cribskip/esp8266_spa/esp8266_spa.jpg

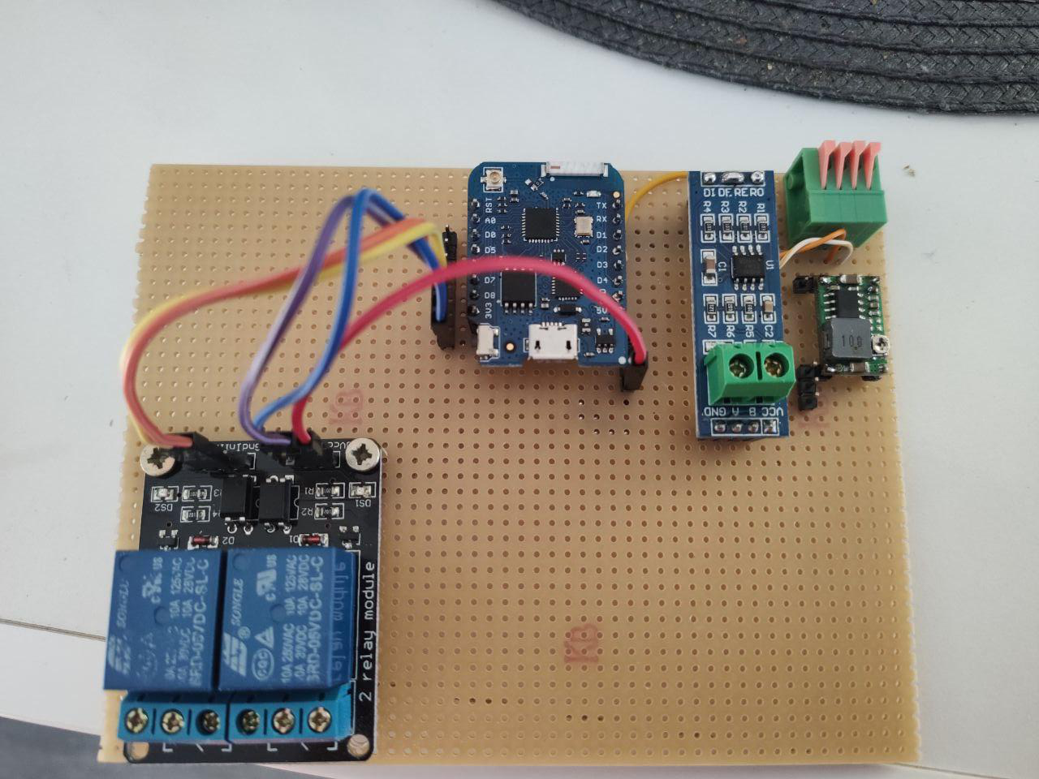
esp8266_spa.jpg
