cribskip/esp8266_spa/(threads)

Thread 1 (2020-08-14):

Not compiling?

tmjo, 2020-08-14:
Hi cribskip! I found your repo when googling for an ESP library for Balboa. I've successfully done a few ESP8266 projects before, but I'm no expert. When I try to compile and upload your code to my ESP, it fails to compile with the following messages:

```
balboa_helper:1:14: error: 'CircularBuffer' was not declared in this scope
 inline uint8_t crc8(CircularBuffer<uint8_t, 35> &data) {
              ^
balboa_helper:1:36: error: expected primary-expression before ',' token
 inline uint8_t crc8(CircularBuffer<uint8_t, 35> &data) {
                                    ^
balboa_helper:1:43: error: 'data' was not declared in this scope
 inline uint8_t crc8(CircularBuffer<uint8_t, 35> &data) {
                                           ^
balboa_helper:1:47: error: expression list treated as compound expression in initializer [-fpermissive]
 inline uint8_t crc8(CircularBuffer<uint8_t, 35> &data) {
                                               ^
esp8266_Spa:53:16: error: variable or field 'print_msg' declared void
 void print_msg(CircularBuffer<uint8_t, 35> &data) {
                ^
esp8266_Spa:53:16: error: 'CircularBuffer' was not declared in this scope
esp8266_Spa:53:38: error: expected primary-expression before ',' token
 void print_msg(CircularBuffer<uint8_t, 35> &data) {
                                      ^
esp8266_Spa:53:45: error: 'data' was not declared in this scope
 void print_msg(CircularBuffer<uint8_t, 35> &data) {
                                             ^
balboa_helper:1:21: error: 'crc8' declared as an 'inline' variable
 inline uint8_t crc8(CircularBuffer<uint8_t, 35> &data) {
                     ^
balboa_helper:1:21: error: redefinition of 'uint8_t crc8'
balboa_helper:1:9: error: 'uint8_t crc8' previously defined here
 inline uint8_t crc8(CircularBuffer<uint8_t, 35> &data) {
         ^
balboa_helper:1:21: error: 'CircularBuffer' was not declared in this scope
 inline uint8_t crc8(CircularBuffer<uint8_t, 35> &data) {
                     ^
balboa_helper:1:43: error: expected primary-expression before ',' token
 inline uint8_t crc8(CircularBuffer<uint8_t, 35> &data) {
                                           ^
balboa_helper:1:50: error: 'data' was not declared in this scope
 inline uint8_t crc8(CircularBuffer<uint8_t, 35> &data) {
                                                  ^
```

It's probably me or my setup, but I would very much appreciate if you could guide me on the way. Using latest Arduino IDE (1.8.13) and already included the required libraries. If I can get it running I would be more than happy to contribute with testing and further development.

Thx.

cribskip, 2020-08-14:
Hi tmjo,

thanks for pointing out. I've seen the code is incomplete. I'll fix it
tomorrow and please check again.

Best regards

tmjo <notifications@github.com> schrieb am Fr., 14. Aug. 2020, 19:11:

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

tmjo, 2020-08-15:
That's awesome! Thanks!!

cribskip, 2020-08-15:
Ok, so I've updated the code to keep up to my local copy. Fixed the missing file and referenced the dependencies (Please install from the Arduino IDE's library manager)

tmjo, 2020-08-15:
Thank you! I tried the new file, but still get the same compilation errors. Read something about the compiler being weird sometimes when it comes to inline functions. Do you know if you have setup anything special to make sure it recognizes the balboa_helper correctly?

I'll do some digging. I should be able to compile it if you are running it, so it must be something with my setup vs yours I guess.

tmjo, 2020-08-16:
Hi again! I think I kindof found the issue. Could it be that your local project folder is "esp8266_**S**pa" with capital S while the github repo is "esp8266_**s**pa"?? Perhaps github is forcing lower case names? Don't even know how I got onto that track, but my folder was all lower case while the main file was with capital letter. This seems to give me the errors that I described in my initial post. Both renaming the folder to capital S or renaming the main file to lower case s removed all those funny compilation errors. Seems strange to me, Arduino IDE was already giving me an error since my initial folder name was directly from the Github download and included "-master" in its name, so I changed to just "esp8266_spa", but it didn't at all complain about the upper/lower case thing. I was able to reproduce the issue both ways several times.

Once that was solved, I still got one compilation error....
```
esp8266_spa:160:24: error: 'class String' has no member named 'toDouble'
     double d = payload.toDouble();

```
.... which seems strange. I googled and found the _toDouble()_ everywhere, but also stumbled over some suggestions of using _toFloat()_ instead.  Replaced line 160 from  _double d = payload.toDouble();_ to float _d = payload.toFloat();_ and it compiles fine. This seems odd to me, but could it be that it has been removed somehow from the Arduino?? As mentioned before, I'm using the latest 1.8.13 of Arduino IDE - do you mind me asking which version you are using? Couldn't find any references on google on if/why it is removed, and it seems odd if it is, so I don't know....

Anyway, now it is compiling, so I'll try it live on my tub tomorrow! Thx.

cribskip, 2020-08-16:
Thank you for your investigations, tmjo :-)
Always great to see helpful people like you.

I'm using Arduino 1.8.12 with esp SDK 2.7.2.

Your guess concerning different names is right - I'm using OpenSpa and renamed it for clarity on github. There I may have introduced the naming trouble. I'll fix it ASAP.

Good luck and keep safe, turn off power.

The code has a problem but mitigatable: https://github.com/cribskip/esp8266_spa/issues/2

tmjo, 2020-08-16:
Great! I thought my esp sdk was updated, but turned out I was on v.2.3.0. Have a vague memory of having to downgrade some time back due to some problems on a previous project, but now I updated to latest v2.7.4 and the toDouble() is working fine. Must have happened something there in between versions.

Another thing, completely unrelated to the "issue", but I'll give it a shot anyway: I just found out that my Balboa panel is connected with a 8-pin Molex and not 4-pin as documented on the ccutrer/balboa_worldwide_app repo. Tried to measure, but found 10V instead of 12V and several 5V instead of 2-3V. Need to investigate a bit more before trying to connect. Any chance you've seen anything about the subject? You have the 4-pin Molex?

tmjo, 2020-08-16:
Closing the issue, thanks for your help!

Closed 2020-08-16.

Thread 4 (2020-10-15):

Topic only shows me Spa/node ON

Magfel, 2020-10-15:
Hi,
I like this project, thanks a lot.
I did all you recommand but when when I include MQTT client, the only command founded is "Spa/Node" with the status ON.
Can you explain me why ? My jeedom seems communicate right with the Wemos D1 Mini pro but not with th tub.

cribskip, 2020-10-16:
Hi,
thank you for the heads up.
Please subscribe to Spa/# as you will then see debug messages on /debug.

In the code are several places with comments to higher the verbosity. Please test these.

Which spa controller are you using? There are differences between controller versions which may cause a problem.

Wemos d1 mini is right.

Magfel, 2020-10-16:
I have a Balboa BP2100G1.
When I suscribe to Spa/# I have only the Spa/node information with a ON status.
Once, I've seen the debug information witch returned -2 ou -4 value, I think.

cribskip, 2020-10-17:
I have the BP2100G0.

| I've set the DC-DC converter to 5V to power the Wemos D1, is it right ?
Perfect :-)

| Is it possible A and B wires inverted ?
That may be the case, please swap them and try again.

Debug is used for several informations. When reconnecting, it publishes the MQTT state before the reconnect (e.g. TImeout etc.) [Docs](https://pubsubclient.knolleary.net/api#state)

Magfel, 2020-10-26:
OK, I have a BP2100G0 too, it was a mistake from me cause I'd downloaded the BP2100G1 datasheet.
Now, it works fine since I've change the Wemos card to an original WEMOS D1 mini pro, I don't known what was the problem with the first one.
I've added a few lines of code to have the possibility of uploading the sketch through the wireless connection.
And I have put all the electronic components in a 3D printed case
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

cribskip, 2020-10-26:
Nice to hear it's working for you also :-)

HTTP-Updater ist already implemented: https://github.com/cribskip/esp8266_spa/blob/b1cb9cef590acb9f651b07251ffd164370011b81/esp8266_spa.ino#L209

Sweat case, could you please post a picture from your setup inside?

Magfel, 2020-10-26:
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
Is is a beta version, I'm going to do one larger.
How do http-updater works ? When I go to the page \\192.168.0.164, I have a blank page with "Not found: /" written on the top left.

cribskip, 2020-10-26:
Use http://ip/update
If asked, use user admin, blank password

Neat setup compared to mine 😅

Magfel <notifications@github.com> schrieb am Mo., 26. Okt. 2020, 20:47:

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

Magfel, 2020-10-27:
Thanks :-)
_Use http://ip/update_ it works, but I prefer using OTA version.
I know why my first "Wemos" card didn't work. On these cards, the pin D1 is the GPIO5 !!!

EmmanuelLM, 2020-12-24:
> Thanks :-)
> _Use http://ip/update_ it works, but I prefer using OTA version.
> I know why my first "Wemos" card didn't work. On these cards, the pin D1 is the GPIO5 !!!

Hi @Magfel I am experiencing the same issue as you but don't understand your last comment as D1 is GPIO5 on my Wemos D1 Pro?? :-/

Magfel, 2020-12-24:
EmmanuelLM,
Try a little program using D1 linked to a LED and test it to be sure it's the real pin used by the program. It was the problem with a copy of the Wemos PRO.

EmmanuelLM, 2020-12-26:
I just checked this and D1 is indeed D1 ... I double-checked my chip as well, which seems to work.
It definitely feels like a hardware issue rather than a software one, but I cannot understand why the program would only post ON and not post the other messages right after it....

cribskip, 2020-12-26:
Excuse me, I'm late back to the discussion ;-)

@EmmanuelLM Did you see this Hint in the code and test it out? Please also post a picture of your setup, thanks
https://github.com/cribskip/esp8266_spa/blob/5f867a4486b858caddb717e2fb8187c5919024d6/esp8266_spa.ino#L245

EmmanuelLM, 2020-12-26:
I did yes, when I get something, it is 254... in fairness, I wonder if my cable is at fault, so I have ordered a new one and will report back when it arrives next week.

EmmanuelLM, 2020-12-30:
I am back with a new cable and still the same issue.... I also noted that the node timeouts every few seconds from the mqtt broker (Mosquitto) and that going to http://ip/update also produces a ERR_CONNECTION_TIMED_OUT - it makes me wonder if the problem is perhaps linked to the network? looks like the node may be trying to reconnect on a regular basis hence the constant Node ON messages... but I don't fully get why I don't receive the debug messages at that point as well...

EmmanuelLM, 2020-12-30:
One other question / possibility why it could not work - I see the Max485 breakout board is a 5V logic vs the wemos d1 mini pro is 3.3v logic, which makes me wonder if the RX/TX are 'overdriven' at 5v, which could cause issues...?

pengemetal, 2020-12-30:
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

Hi Everybody,

I am very happy to find this topic! :). I have the same Balboa BP2100G1 control panel. Could you explain where i can plug Wemos D1 to the panel? The J34 wifi socket? And the DC-DC converter, is it coming from Led 12V? Could you give me some more information about wiring? Thx in advance

cribskip, 2020-12-30:
@EmmanuelLM
Ok, so your cable seems to be good. Maybe the wifi distance is your problem but in this case, you may still see the RECONNECT message. What's the Reconnect reason when the node reconnects? How many millis has the node been running? Or do you ONLY see Node Online?

@pengemetal
Yes, you are right, the hook up documentations is rather sparse ;-) The stock display has a 4 pin molex-type connector with +12...15V, GND and A+B. All connections are on the wire and needed. Please also see the referenced https://github.com/ccutrer/balboa_worldwide_app/wiki#physical-layer for further details. The LED 12V supply for the RGB lighting in the spa is NOT being used.

Testing for correct cabling to the SPA, you can also hook up a USB TTL UART to the RO Pin of the Max485 and bridge RE/DE to GND. You should see plausible data at 115200 8N1.

EmmanuelLM, 2020-12-30:
Hi, I don't see the reconnect message, and spa/debug reports -1 (when it does), with a spa/rcv of 254.

cribskip, 2020-12-30:
Just for testing, please swap a and b

pengemetal, 2020-12-30:
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

Thank you for your answer! Just one more question: Could you help mi about relays wiring? What are they doing? Thx

EmmanuelLM, 2020-12-30:
> Just for testing, please swap a and b

Will try, i'll also hook up a usb ttl for kicks!
Did you see my other comment about the max485 being a 5v chip?

cribskip, 2020-12-31:
@EmmanuelLM 5v is OK for newer chip revisions since a few years. Unless you took a trip to the museum you should be fine.

@pengemetal the relays in the picture were to switch on external lamps. Then for J29 (power shedding of the heater) meanwhile, they are near to useless because I've attached a good and cheap heat pump and disconnected the internal heater (code to come)

Magfel, 2020-12-31:
> I am back with a new cable and still the same issue.... I also noted that the node timeouts every few seconds from the mqtt broker (Mosquitto) and that going to http://ip/update also produces a ERR_CONNECTION_TIMED_OUT - it makes me wonder if the problem is perhaps linked to the network? looks like the node may be trying to reconnect on a regular basis hence the constant Node ON messages... but I don't fully get why I don't receive the debug messages at that point as well...

Hi EmmanuelLM, Does the wifi signal strong enough ?

EmmanuelLM, 2020-12-31:
Hi, Wifi is good, i am a few meters away from the router, I have also tried switching A & B with the same result.
The one other difference I can think of vs the native code is the change mqtt.connect to take into account authentication so mqtt.connect("EspSpa", "login", "password")

I have a usb - ttl coming later today so will do a step by step to ensure my tub is actually producing something (the display works so I think the answer is yes) and work my way backwards to diagnose the issue... if helpful to anyone, this device seems to be able to do it all! https://www.ebay.co.uk/i/202172720183

EmmanuelLM, 2020-12-31:
News from the front: it works!!!!
The issue was the RS485 to TTL module that I was using, I ended up swapping it over to a "ARCELI TTL To RS485 Adapter 485 Serial Port UART Level Converter Module 3.3V 5V" and it now works flawlessly. I will push over some changes to the doc to add a diagram and help other people who might come across here.

The only last issue I have is the wemos d1 mini pro does not 'boot' by itself with the current power rail, I need to first connect it to a usb power supply and then it works as expected (including resets...) - how strange...

cribskip, 2020-12-31:
@EmmanuelLM thanks for the update and great it works. Rather strange with the power supply. PR welcome 😅

EmmanuelLM, 2021-01-03:
Hi, I have started making changes to the code, mainly to deal with the following:
- remove the need for D1 with the RS485/TTL converter
- add support for Home Assistant autodiscover support
- deal with spurious temperature readings (not sure if that was just me?)
- shuffle the mqtt message structure and add more debug info
I migrated the files to PlatformIO as I find it easier to develop on that - this does mean the source file is not in the same location as yours and I have not yet figured out how to make a pull request from alternative folder locations... once I do, I will send PRs
You can see changes here in the meantime: https://github.com/EmmanuelLM/esp8266_spa/blob/master/src/esp8266_spa.ino
If you go to the root of the fork, you will see I also updated the documentation, I will send a PR for that

Thread 5 (2020-11-14):

"Nothing to send" not handled correctly?

irekzielinski, 2020-11-14:
Hi. Thanks for your project, it's a great starting point!
While comparing code to the specification I noticed that it's not handling "Nothing to send".
According to: https://github.com/ccutrer/balboa_worldwide_app/wiki#nothing-to-send

"Nothing to send" should be sent when "Clear to Send" is received but we have no update.
Right now code will send "Toggle Item Request" instead with byte 0x00 - this does not seem to be correct.

Here is the amended code (send == 0x00):
```
       if (send == 0xff) {
          // 0xff marks dirty temperature for now
          Q_out.push(id);
          Q_out.push(0xBF);
          Q_out.push(0x20);
          Q_out.push(settemp);
        } else if (send == 0x00){
          // A Nothing to Send message is sent by a client immediately after a Clear to Send message if the client has no messages to send.
          Q_out.push(id);
          Q_out.push(0xBF);
          Q_out.push(0x7);
        } else {
          // Send toggle commands
          Q_out.push(id);
          Q_out.push(0xBF);
          Q_out.push(0x11);
          Q_out.push(send);
          Q_out.push(0x00);
        }
```

Let me know your thoughts.
Cheers,
Irek

cribskip, 2020-11-15:
Thanks Irek, I'll try it out when time (and weather ;-)) permits.

I've deliberately done it this way as it's the same behaviour of the original controller in my case.

Are you also using a balboa spa? Which controller then?

Best,
Sascha

irekzielinski, 2020-11-15:
Hi, interesting that your controller sends 0x11 in this case.
I have Balboa VL600S and it sends 0x7. Possibly both are OK.
Thanks!
Irek

ps. noticed that RO pin is directly to RX in Wemos. I think RO can go up to 5V which is higher than spec for Wemos. I put a level shifter in my implementation (voltage divider would also do). There are people that have wemos working on 5V input pins for years, other say board can get damaged over time. Did you see any long term issues with serial or board stability?

cribskip, 2020-12-26:
Hi,

thanks for your feedback on the VL600s behaviour.

No, it's up and running smooth for about three months. Its up to the chip revision if they can stand 5V in or not. Older revisions did not while newer ones do.

Did you build the project yourself?

Cheers,
Sascha

Magfel, 2020-12-31:
Hi,
I've a similar problem. I can send orders to the tub about 2 hours after powered on the Balboa controller. After this laps time, I can only receive messages and it works all the time. If I have to send another message passed this 2 hours, I have to swith off and on the controller Balboa.  It is probably caused by the byte 0x11 instead of 0x07 as says irekzielinski.
What do you think  ?

irekzielinski, 2020-12-31:
Hi Sascha. Yes I build the project myself - your code was a great help! Thank you.

> EDIT: Just pasted the code you thanksfully provided in and noticed a missing 0 with the message type code. It's 0x07 instead of 0x7. Thank you :)

There is no difference between 0x07 and 0x7 - it is the same value of 7. Might be worth doing this for the esthetic reasons but compiler will generate the same code in both cases.

Kind reagrds,
Irek

irekzielinski, 2021-02-17:
> Hi,
> I've a similar problem. I can send orders to the tub about 2 hours after powered on the Balboa controller. After this laps time, I can only receive messages and it works all the time. If I have to send another message passed this 2 hours, I have to swith off and on the controller Balboa. It is probably caused by the byte 0x11 instead of 0x07 as says irekzielinski.
> What do you think ?

I heavily modified the code - but main difference is that I send 0x11 and use level shifter to convert from 3.3V to 5V when interfacing with RS485. My controller is rock solid - working for months without any reboot, lost connection or change of ID (ID is assigned on first data exchange with Balboa mainboard).
I recommend to do both modification.

cribskip, 2021-02-17:
Thanks for your feedback and optimization recommendations @irekzielinski ! Very apprechiated!

Did you try the current version yet? Very cool with the homeassistant auto detection and configuration parser! Great work from @EmmanuelLM

Closed 2021-11-26.

Thread 7 (2021-02-03):

No Topic messages

w4Rd3n, 2021-02-03:
Hello.
Thank you all for the great work on this.
I have some problems with the fork of Emmanuel:
https://github.com/EmmanuelLM/esp8266_spa

I use a Wemos D1 mini  Pro
and this config:
```
#define VERSION "0.32"
#define WIFI_SSID "TP-Link_F526"
#define WIFI_PASSWORD "******"
#define BROKER "192.168.1.170"
#define BROKER_LOGIN "loxberry"
#define BROKER_PASS "********"
#define AUTO_TX true //flag for the RS485/TTL chip - i.e. do we need to pull D1 or not....
```

At the moment i don't have the spa connectet to the RS485  TTL transceiver.
But anyway i should get some mqtt messages, no ?
I am powering the wemos on the 5V input with my DC-DC converter

So far Wemos is connected to my wifi but i dont receive any spa  message on my broker.
i am subscribed to Spa/# topic.

Here is a photo of the HW:
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

w4Rd3n, 2021-02-03:
I don't use external Antenna on the D1 mini for now. Ping is working but usually 1 of 4 packets are lost wheni execute the command.
The Webserver is not working. it keeps saying connection timeout and then reloads page

cribskip, 2021-02-03:
@EmmanuelLM s fork is tested with me in PR #6 but up to now, my tests were not successful besides the code looking great.

Maybe you should try my current code first to debug potential connectivity issues as it publishes when the wemos connects to the broker.

EmmanuelLM, 2021-02-03:
My fork is "work in progress" ;-)

From my experience, I had issues with the RS485 to TTL transceiver and found [and I do not know why] that the device would just not work if it didn't receive messages (c.f. issue #4)...

I agree with @cribskip - test his code first :)

p.s. #define AUTO_TX true -> this should be false with your transceiver

w4Rd3n, 2021-02-04:
Thanks for your inputs.
For now i only powered the board without the spa connection.
i was assuming i ll get some mqtt messages also without the spa connected.
I will let you know how this continues :)

Michael0yodi, 2021-06-01:
Did you ever find any solution I've similar issue, I can see that it reports to my broker

1622540317: New connection from 172.16.0.121 on port 1883.
{"result": "ok", "data": {}}1622540317: New client connected from 172.16.0.121 as Spa8861 (p2, c1, k10, u'mqttuser').
1622540332: Client Spa8861 has exceeded timeout, disconnecting.
1622540338: New connection from 172.16.0.121 on port 1883.
1622540338: New client connected from 172.16.0.121 as Spa8852 (p2, c1, k10, u'mqttuser').

But no matter if connected or not to the spa I never get any data via mqtt
webserver on D1 just give me this "Not found: /" not sure if expected?

I've it running on usb power without using the dc-dc converter, but since ground is not connected on the rs485 I guess it "should" work, rxd is flashing so looks like data is received

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

EmmanuelLM, 2021-06-03:
Hello, a few things as it looks like you are nearly there.

If you are powering off usb (or anything else), you need all GND to be connected together otherwise the signal 'floats' - likewise, with the hot tub GND.

if you go to the webserver, go to http://you_ip/update - nothing shows in the root as you have seen.

pato-loco, 2021-06-14:
@EmmanuelLM what do you mean with "all GND to be connected together"?

EmmanuelLM, 2021-06-14:
I meant that the following GND connections should all be connected together:
- power supply GND
- circuit GND
- Hot Tub connector GND

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

Michael0yodi, 2021-07-04:
I've tried to make sure that gnd are common with the spa using a dc-dc converter, but it still behaves the same so not sure where to start troubleshooting, any ideas are welcome

pato-loco, 2021-07-04:
> I've tried to make sure that gnd are common with the spa using a dc-dc converter, but it still behaves the same so not sure where to start troubleshooting, any ideas are welcome

put (-) from the DC-converter "in" and (-) from the DC-converter "out" directly together.

Michael0yodi, 2021-07-04:
should I also connect the GND on the RS485 transceiver? I've used RS485 before with no common ground so its a bit strange that its not working at all, could of course be something else also..

tonyfitzs, 2021-09-28:
hi there, I am also having issues with MQTT. as reported above, I can see in the logs of my broker that the D1 Mini running this code is trying to connect to the brocker and its trying to send a message as follows

1632863671: New connection from 10.110.x.x on port 1883.
1632863671: New client connected from 10.110.x.x as Spa1 (p2, c1, k10, u'test').
1632863665: Client Spa1 has exceeded timeout, disconnecting.

but the subscription isnt ever completed before it disconects. i am wondering if the code I am using is the right version (VERSION "0.35"), because the webpage, dosnt do anything either, and based on above it looks like it is suposed to. if I try to hit http://10.110.x.x/update I get a page time out. perhaps I am misunderstanding the purpose of this url, because the documentation has a few gaps, is this an OTA address rather than a webpage that shows you information.

EmmanuelLM, 2021-09-29:
Hey there, thanks for trying the project.
In my experience with this type of issue, the problem ended up being the
RS485 TTL transceiver - the chip reboots itself when it doesn't receive any
messages on the bus, so the behaviour below is expected.

If you have not already, I highly recommend getting the ARCELI TTL To RS485
Adapter 485 Serial Port UART Level Converter Module 3.3V 5V for the simple
reason you don't need to mess about with levels.

If you already have this chip, you can buy a cheap rs485 TTL usb debugger
that you can hook up to your laptop to check messages are coming through.

Good luck!

P.s. the OTA page is just for updates but it won't be available as the
device reboots itself.
P.p.s. there is a newer firmware on my fork

On Tue, 28 Sep 2021, 23:21 Tony Fitzsimmons, ***@***.***>
wrote:

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

tonyfitzs, 2021-09-29:
Hi Emmanuel,

Thank you for taking the time to get back to me. I have high hopes for this project. So first, let me clarify a few things; I have purchased the hardware that you recommended on your GitHub page. That means I have a D1 mini pro, and I also have an  ARCELI TTL To RS485 (https://www.amazon.co.uk/ARCELI-Adapter-Serial-Converter-Module/dp/B07DN115BZas) before I go out and mess around under my house to connect all this up to my spa (My spa is built into the floor of my rear entertainment area) I want to make sure this all works on my workbench. So I also purchased a cheap RS485 to USB (https://i.ebayimg.com/images/g/~n0AAOxyItRTefGv/s-l500.jpg) as well.

I am also going to create a small app to help me with testing using C#. This will basically replicate the spa's settings and generate a simulated message as if your spa was connected to the communication port. Once I have that all working, I will share the project because I think it will be useful for others following after us. So as the first step in that process, I am trying to get basic communications up and running between the Rs485 dongle and the D1 Mini project. This is where I am having a lot of trouble, and im trying to narrow down the variables to make sure it's not my hardware.

So what's happening is I have the d1 mini, and the ARCELI TTL To RS485 all set up, I have installed your code (VERSION "0.35") onto my d1 mini, and I have connected the A and B data lines between the TTL To RS485 and the Rs485 dongle. Once the D1 boots up after loading the code, I open the terminal to see what it is sending (this is the screenshot on the left below) I also open a terminal against the USB port (on the right), and I can clearly see that the D1 is sending messages to the USB dongle, I send a sample message (7e 20 ff af 13 00 00 ff d 2a 00 00 67 67 00 04 00 00 00 00 00 00 00 00 00 66 00 00 00 78 00 00 52 7e) I can see that the D1 mini is responding with

wdt reset
load 0x4010f000, len 3460, room 16
tail 4
chksum 0xcc
load 0x3fff20b8, len 40, room 4
tail 4
chksum 0xc9
csum 0xc9
v000731e0
~ld
fpm close 3
mode : sta(a0:20:a6:0d:d6:ba)
add if0
scandone
state: 0 -> 2 (b0)
state: 2 -> 3 (0)
state: 3 -> 5 (10)
add 0
aid 3
cnt

So far, so good.

***@***.*** ***@***.***

The issue I am now having is that I can't seem to get it to connect to my MQTT broker,

In the broker logs, I get this message repeated over and over again
1632903370: New client connected from 10.110.10.147 as Spa1 (p2, c1, k10, u'test').
1632903386: Client Spa1 has exceeded timeout, disconnecting.
1632903391: New connection from 10.110.10.147 on port 1883.

And I can't see a topic for the spa being generated. Based on what I can see in your code, I think it should be reporting something like Spa/<topic>/<state> but its not.

Anyway, if you can help, I would appreciate it.

Also, I would like to help you out with improving the readme you have created because there are a lot of gaps in the explanation, which makes it a lot hard when you are having trouble like I am. Once I have this all up and running, I would be very happy to re right this for you and send it to you so you can post it if that's of value to you.

Thanks for your time

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

EmmanuelLM, 2021-09-29:
One quick question: the system is not yet hooked up to the Spa, correct? If
that is the case, I don't think the system will work because it will reboot
itself when it doesn't receive messages after a while.

On Wed, 29 Sep 2021, 10:22 Tony Fitzsimmons, ***@***.***>
wrote:

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

tonyfitzs, 2021-09-29:
Yes that's correct.

Ok that makes sense. In that case I will get my little balboa Spa simulator working and revert...

But what about the mgtt question.

Sent from my Galaxy

-------- Original message --------
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

Thread 8 (2021-02-04):

Subscribe doesn't match callback handler

cribskip, 2021-02-04:
https://github.com/cribskip/esp8266_spa/blob/a16ca98d76dbf3ae4b159a9b4e59057b788d7a5f/src/esp8266_spa.ino#L494

Relays wont work this way

Closed 2021-02-04.

Thread 9 (2021-02-05):

RS485 bus transceiver wiring

pengemetal, 2021-02-05:
I have this type of RS485 bus transceiver, could you help me about wiring? Thx
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

EmmanuelLM, 2021-02-14:
Evening, I had a lot of trouble with this transceiver so ended up getting a ARCELI TTL To RS485 Adapter 485 Serial Port UART Level Converter Module 3.3V 5V, so I would recommend getting one of those.
The main differences are:
- it natively runs at 3.3v or 5V
- you don't have to mess about with pulling D1 to transmit data
- it has some flashing lights that shows data being received / sent [helpful for debugging connections]

pengemetal, 2021-02-15:
Thx, I'll try to order this  transceiver!

pengemetal, 2021-03-31:
Hi, All parts have arrived I would start to make the connection. One question: I haven't got molex cable or Y splitter, is it possible to cut the display cable and with some Wago make DIY y-splitter cable? How did you wire to the motherboard? Thx!

EmmanuelLM, 2021-03-31:
I mean... everything is possible and what you suggest is (in essence) a Y-slitter.
I got a mini Molex cable and connected to the spare port.

One question for you (and whoever else is ready this) - would there be any interest in buying a made-up system? Thinking out loud, I am thinking the whole system + 3d printed case would probably come to ~50USD or so?

EspenT, 2021-03-31:
Yes, for 50usd I would buy 😊 I´ve been following this thread forever and probably have everything I would need to make it, except time.

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

pengemetal, 2021-03-31:
Thx for the quick answer! I think it is a fair price for it!

EmmanuelLM, 2021-04-01:
Sounds like I need to have a look at getting the wifi hotspot working then!

cribskip, 2021-04-02:
@EmmanuelLM please add a connector for J2 (IIRC) to control the heater. That way controlling the circulation is possible and other cool things.

Currently I use a relay but an transistor should suffice

mopac, 2021-07-06:
I realise it is a little late for the original poster, but just for completeness, I show here my schematic and a few photos of how I used this RS485 board.
I use a D1mini power sheild to regulate the hot tub 12V supply down to 5V for the RS485 board and the D1 Mini Pro. (D1 Mini Pro has its own regulator from 5V down to 3.3V.
The RS485 board is 5V, while D1 mini Pro is 3.3V. All outputs from D1 Mini Pro work just fine with a direct connection. The RX input - RO output from the RS485 board is the only issue. The fix is a schottky diode in this signal line. Schottky diode because of the low forward voltage. I used a BAT43 diode.
Tx & Rx used for the RS485 board are also connected to the USB-UART converter on the D1 Mini Pro but there are 470 ohm series resistors so they can be overdriven.
I use GPIO13 & GPIO15 for enabling the Receiver and Transmitter respectively. This is because GPIO13 has a pull-up on the D1 mini and GPIO15 has a pull-down. So if software doesn't configure these GPIO, the RS485 board is disabled. The benefit is that Serial download still works.
The only annoying tweak is that R3 on the RS485 board needs to be removed. This is a pull-up resistor that conflicts with the pull-down resistor on the GPIO15 on D1 mini Pro.
The only changes in the code are to configure the two GPIO as outputs and set LOW in the 'Setup' function. And ensure both GPIO are set HIGH then LOW in the 'rs485_send' function
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

Closed 2022-01-10.

Thread 11 (2021-04-05):

Wemos keeps resetting

micv83, 2021-04-05:
I’ve tried with 2 different wemos d1 mini, but after it connects to WiFi it disconnects again crashes with wdt reset.

what Couple be wrong ?

cribskip, 2021-04-05:
Power Supply ok?
Please post a photo of your setup

micv83, 2021-04-05:
The resets occurs even when hooked up to the laptop via usb, with only the Wemos - no regulator or rs485 attached. I have also tried standalone setup with 12v psu through regulator with rs485 attached.
I do get connection attempts in mosquito in home assistant, so it does something before it crashes...

Like this:
1617639019: New connection from 192.168.1.78 on port 1883.
1617639019: New client connected from 192.168.1.78 as Spa1 (p2, c1, k10, u'mqtt').
1617639034: Client Spa1 has exceeded timeout, disconnecting.

EmmanuelLM, 2021-04-06:
Hi, in my experience the device resets when it doesn't receive messages from the hot tub (see: https://github.com/cribskip/esp8266_spa/issues/7#issuecomment-772675742).

I am afraid you're going to have to hook it up to resolve that one :)

micv83, 2021-04-06:
Thank you srasmond - this was the issue, it stays connected now, and I am more confident trying to connect it to the spa now 😊👍🏼

cribskip, 2021-04-06:
@micv83 Good luck then! What controller do you have?

micv83, 2021-04-07:
It’s a Balboa bp6013g1 hope it works 😊

srasmond, 2021-04-07:
> It’s a Balboa bp6013g1 hope it works 😊

I got the same. Works brilliant, I control it via OpenHAB (Mosquito as broker). Already quite some things you can monitor or change

EmmanuelLM, 2021-04-07:
Hey @srasmond - what other features would you like to see implemented? I am currently working on an access point mode, so I can start releasing binaries, which would make the initial setup much easier, but wondering whether there are other things I could also knock off people's wish list?

cribskip, 2021-04-07:
@EmmanuelLM setting filter cycles and wifi manager would be great.

I'm currently polishing my heat pump controller and write up of the setup and photovoltaik optimization 😉

micv83, 2021-04-07:
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

Managed to get it working, but it’s not all that stable at the moment, but I can see the WiFi signal is very poor, so I’ve ordered a wemos with external antenna connector hope that makes the switches work more reliable 😊

srasmond, 2021-04-09:
@EmmanuelLM I am still playing around with some settings. Currently, my main goal was to set off the heating of the hottub during the night (with a minimum temperature of 21° C, but that is only a concerning during winter). At the moment I am realizing this by setting the "target_temp" lower each night (via openHAB rule). I tried to just turn of the heater and thought it does seem to work, there seems to be 2 issues in this scenario:
- If you don't use the hottub for some hours, the temperature will actually be a "null" value, which requires to turn on the jets for a couple of seconds.
- If you turn on the jets, it seems like no matter what, the heating mode is overruled and it heats up anyway.
- Because of this you cannot continuously compare the current temperature, nor have a trustworthy method of turning of the heater.

--> Setting the target temperature provides a more ensuring way that the hottub will indeed not heat during that amount of time and as a plus, it seems like in this case you get continously updates current temperature values.

Other things I am thinking about:
- Filter cycles, but I see that there is a pull request for this, this seems like a really nice addition! Thanks!
- Setting the time (needs to be done manually now after hot tub is turned off or changing of winter- to summertime) --> important for the filter cycles.
- Really nice would be if we had some way of controlling the amount of power that the heater is taking for example. Most of the time, I am using the hottub after 6 PM, so during the day, when I give the chance to heat up, it would be nice if I could spread out the amount of power, so we don't get peaks but a more slower heating up during sun hours (to take full advantage of my solar panels).
- Control over the lights: at the moment I can only turn the lights on or off, but it seems it always is using the light looping mode (so looping over each color) and on a fast pace... Maybe I am using it wrongly at the moment, but if not it would be nice if we could set the color (or looping on/off) and the tempo (in fixed steps probably) of the lighting. In that scenario, I can also imagine that we can read out the current light color value and for example pass it to other smart lights in the house or garden to get a really nice effect.
- The ability to control / turn off the info messages on the panel on the jacuzzi.
- Setting a "vacation" mode: I guess this can be done by setting "heatingmode" to off (=ready vs rest mode)? Or what is the difference between head_mode and heatingmode?

srasmond, 2021-04-09:
@micv83 Getting an external antenna is a good idea. The default is indeed not strong enough (in my case for example, the signal needs to get from inside its case, which is inside the hottub (close to the balboa controller), which stands outside in the garden, to inside my house - to the closest receiver. Considering also the extra interference by all the wiring inside the balboa controller and perhaps even a bluetooth device next to it, getting a decent antenna is the minimum. After that, you should be all good.

cribskip, 2021-04-11:
@srasmond I'll try to answer to your rather long text structured ;-)

Heater off during winter:
You're right, when the temp is low AND "Balboa M7" "Artificial Intelligence Blockchain Crypto" is turned OFF, you're getting 0 as current temperature as the temperature is unknown to the controller. When M7 is on, the tub starts the circulation just before invalidating the temperature for a few minutes and knows the temperature again.

When you start the jets, the tub goes into ready-in-rest mode: Meaning it's heating to the Ready-Temperature.

My current setup (which needs to be described more in detail ;-) which circumvents all those problems:
- J2 on the tub mainboard it connected to a relay (J2 controlles wheater the tub is allowed to turn on the heater)
- J2 closed: Heater allowed, J2 open: not allowed
- (I disconnected the immersion heater and installed an external controlled heatpump...)
- When the tub invalidates the temp, I simply open J2 and set the tub to Ready mode. Circ starts and a few minutes later I set mode to Rest.

Some benefits:
- Heating is controlled by the heat pump which is cheaper and more environmently friendly
- A new "circulation only" mode is possible which is great when tubbin' because we have a fountain which is linked to the ever switching circ pump in ready mode...

TL;DR: I need to get my documentation ready. But first: more photovoltaic :-D

srasmond, 2021-04-12:
@cribskip The J2 connector would be my alternative to put a wifi switch relais on if I would not get the controller to work.
Now that I can control the hot tub in many other ways, I don't see an immediate benefit from using the J2 connector, but I am curious on what you mean exactly with the "circulation only" mode?

At the moment I am using the "target_temp" since a couple of days, and I have to say it works really well this way. At 10 pm a script is setting the "target_temp" to 30°C and at 10 am a script is setting the "target_temp" to 38°C again. This also makes sure that the current temperature is always known (during heating up or cooling down moments), which is handy, because now I see how much the T is dropping during the night (at the moment it never drops below 34,5 °C).

When light control, time and power control (will most likely need to be done at input level, not via the controller) is added to my system, for me it will have everything I would ever need.

If I have some time this week I will try to put my system, configuration, use cases, etc. on paper. You can then use whatever you want from it in future documentation.

pengemetal, 2021-04-15:
Hi! I use wemos D1 mini (not pro) how can I check the wifi connection? I can't see nothing in MQTT explorer, I think Wemos do not connect to wifi (SSID and password is correct is src/esp8266_spa.ino. Thx

srasmond, 2021-04-15:
@pengemetal you could try to ping it. If it's connected you should also see it in your network list with all devices. Nornally, when using the code from this repo, the Wemos should broadcast its own SSID as well, so in the list of wifi network it should be visible as well.
Other things you could check is the serial output when connected with the board via usb.

pengemetal, 2021-04-15:
> @pengemetal you could try to ping it. If it's connected you should also see it in your network list with all devices. Nornally, when using the code from this repo, the Wemos should broadcast its own SSID as well, so in the list of wifi network it should be visible as well.
> Other things you could check is the serial output when connected with the board via usb.

Ping do nothing. I can see an ESP-xxxxxx SSID, but I use many esp I don't know it's wemos. I tried Platformio serial monitor, but without any success:
> Executing task in folder esp8266_spa-master: C:\Users\Admin\.platformio\penv\Scripts\pio.exe device monitor <

--- Available filters and text transformations: colorize, debug, default, direct, esp8266_exception_decoder, hexlify, log2file, nocontrol, printable, send_on_enter, time
--- More details at http://bit.ly/pio-monitor-filters
--- Miniterm on COM7  9600,8,N,1 ---
--- Quit: Ctrl+C | Menu: Ctrl+T | Help: Ctrl+T followed by Ctrl+H ---
���␙
��D�������␄!>�@���H!�4�L�����?

pengemetal, 2021-04-15:
At baudrate 115200:

wdt reset
load 0x4010f000, len 3584, room 16
tail 0
chksum 0xb0
csum 0xb0
v2843a5ac
~ld

pengemetal, 2021-04-18:
I tried with a NodeMCU v3, problem the same:

wdt reset
load 0x4010f000, len 3584, room 16
tail 0
chksum 0xb0
csum 0xb0
v2843a5ac
~ld

srasmond, 2021-04-18:
@pengemetal and did you try the solution from higher in this post (disabling the reset function)?

pengemetal, 2021-04-18:
> @pengemetal and did you try the solution from higher in this post (disabling the reset function)?

I need to delete this row?
if (WiFi.status() != WL_CONNECTED) {
//hardreset();
}

Thx

srasmond, 2021-04-18:
No, you just need to comment out the hardreset function where needed. The // in the example you showed is a way of commenting a line (so you don't need to delete it and easily can activate it again afterwards).
For testing I suggest disabling the hardreset for the wifi connection, but also for the serial check (if the device is not hooked up correctly, it will keep resetting as well).

pengemetal, 2021-04-18:
> No, you just need to comment out the hardreset function where needed. The // in the example you showed is a way of commenting a line (so you don't need to delete it and easily can activate it again afterwards).
> For testing I suggest disabling the hardreset for the wifi connection, but also for the serial check (if the device is not hooked up correctly, it will keep resetting as well).

Notthing has changed :( messege still the same

EmmanuelLM, 2021-04-18:
Are you connected to the hot tub yet, or is that solo?

pengemetal, 2021-04-18:
> Are you connected to the hot tub yet, or is that solo?

Both

EmmanuelLM, 2021-04-19:
Looks like a potential compile/flash error as you shouldn't see any ESP-xxxxxx SSID

 Questions to help debug:
- are you using atom/platformio to compile?
- do you know the memory size of your chip?
- A guess is your chip has a lower flash size - have a look at "board_build.ldscript = eagle.flash.4m3m.ld" and change to "board_build.ldscript = eagle.flash.1m0.ld"

srasmond, 2021-04-19:
@EmmanuelLM , why shouldn't you see any SSID? There is nothing in the code that prevents the esp from broadcasting the SSID. I see it as well.
It's a nice tip hoever: people should prevent this broadcasting or put a WPA key on the esp. Else you have a potential security issue at hand.

I do however also believe that there might be some flash error in this case like you suggested. Nice suggestion concerning the lower flash size!

pengemetal, 2021-04-20:
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

Thx for your effort!

- I use platformio (Visual Studio Code win10)
- I use Wemos d1
- I flashed NodeMCU v2 and the result was the same, I think Nodemcu has different chip. I will try your suggestion, where can I change "board_build.ldscript = eagle.flash.1m0.ld"?

pengemetal, 2021-04-21:
I changed it in platformio.ini, but I get this:

Error: Could not find 'eagle.flash.1m0.ld' LD script in LDPATH 'C:\Users\Admin\Downloads\esp8266_spa\esp8266_spa-master\.pio\build\d1_mini_pro C:\Users\Admin\Downloads\esp8266_spa\esp8266_spa-master\.pio\build\d1_mini_pro\ld C:\Users\Admin\.platformio\packages\framework-arduinoespressif8266\tools\sdk\lib C:\Users\Admin\.platformio\packages\framework-arduinoespressif8266\tools\sdk\ld C:\Users\Admin\.platformio\packages\framework-arduinoespressif8266\tools\sdk\libc\xtensa-lx106-elf\lib C:\Users\Admin\.platformio\packages\framework-arduinoespressif8266\tools\sdk\lib\NONOSDK22x_190703'
Error: Could not find 'eagle.flash.1m0.ld' LD script in LDPATH 'C:\Users\Admin\Downloads\esp8266_spa\esp8266_spa-master\.pio\build\d1_mini_pro C:\Users\Admin\Downloads\esp8266_spa\esp8266_spa-master\.pio\build\d1_mini_pro\ld C:\Users\Admin\.platformio\packages\framework-arduinoespressif8266\tools\sdk\lib C:\Users\Admin\.platformio\packages\framework-arduinoespressif8266\tools\sdk\ld C:\Users\Admin\.platformio\packages\framework-arduinoespressif8266\tools\sdk\libc\xtensa-lx106-elf\lib C:\Users\Admin\.platformio\packages\framework-arduinoespressif8266\tools\sdk\lib\NONOSDK22x_190703'

srasmond, 2021-04-21:
Could you try with eagle.flash.1m.ld (so without the "0").
Also a link that could be of intrest in this case :
https://docs.platformio.org/en/latest/platforms/espressif8266.html#flash-size

pengemetal, 2021-04-21:
I tried, flash is perfect, but the wdt fault is still existing :(

srasmond, 2021-04-21:
How is your esp currently powered for testing? I'm guessing you are just plugin it in via an usb adapter to the laptop, so you can check the messages in the serial monitor?

pengemetal, 2021-04-21:
Yes, laptop via usb.

EmmanuelLM, 2021-04-21:
This may not work as terminal is taken over to communicate with the hot tub.
I find your issue very odd - can you try flashing something else on yoru
chip?

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

pengemetal, 2021-04-22:
Yes, I flashed with esphome and worked perfect! I am thinking about using a D1 mini pro. I have one, but it is built for control sauna.

pengemetal, 2021-05-04:
I try a D1 mini pro, almost the same result, but now I can see nothing in serial monitor. I think the main problem is connecting to wifi. I can't see Wemos fixed ip in the network. When I flash esphome, there is no problem.

pengemetal, 2022-01-10:
> @pengemetal Can this be closed? Is your issue resolved and you can enjoy the sketch?

Yes, thank you! It solved, I dont know what was wrong, I think the wifi signal was the problem! Finally the sketch works great! :)

Closed 2022-01-11.

Thread 13 (2021-04-06):

Warning about MT3608 suggestion

srasmond, 2021-04-06:
In the README, we can find the following information: "A DC-DC converter for powering from the Tub (MT3608 for example)".
However, the MT3608 is a step-up converter, while you will definitely want a step-down converter.
Its step-down counterpart for example is the "LM2596".

Just a little warning for those like me who forgot to look into the difference between step-up and step-down converters.

cribskip, 2021-04-06:
Corrected, thank you very much

Closed 2021-04-06.

Thread 15 (2021-04-16):

OTA Update And HASS Client

qwacko, 2021-04-16:
Hi, Thanks heaps for the logic. I had been trying with Micropython to get this going, but I was just unsuccessful at getting it to go. Then just a couple of hour and I got your solution going. It would be great to get this as part of ESPHome, but I think the refresh rate may be too low.

Anyway, I have made a couple of changes to my version of the code to make it work how I wanted, and thought you may appreciate these minor code changes.

**Arduino OTA**
I see you had a note to get OTA to work (and even had the library included). The logic changes to make this are:

Just incude ArduinoOTA.begin(); in the setup task.
`void setup() {
   ...
   ArduinoOTA.begin();
   ...
}
`

And include the ArduinoOTA.handle at the start of the loop:
`void loop() {
  ArduinoOTA.handle();...`

And it will be ready. Once you have done this intial serial download, then you can add the following lines to the platformio.ini file:
```
upload_protocol = espota
upload_port = spa.local
```

And through the magic of mDNS it will be able to do a download to it. This is great for debugging while it is connected to the SPA.

**HASS Client**
I noted that the HASS client was only working for some items. Most markedly the Climate item wasn't working, this is due to the default message length limit of 256B. You may have fixed this by modifying the PubSubClient.h file in your instance (or maybe the climate just hasn't worked for you). To make it work for me, I added the "setBufferSize" comand when the mqtt service is setup.

```
  mqtt.setServer(BROKER.c_str(), 1883);
  mqtt.setCallback(callback);
  mqtt.setKeepAlive(10);
  mqtt.setSocketTimeout(20);
  mqtt.setBufferSize(1024); // Set buffer size to allow discovery messages to work correctly.
```

EmmanuelLM, 2021-04-19:
Sweet - please could you send a pull request vs 0.36 (c.f. my branch)?

also see line 488 for setBufferSize - I had increased it to 512, was that not enough?

flechaig, 2021-12-22:
In my experience with a Balboa BP6013G2, I had to set :
`mqtt.setBufferSize(1024);`
for everything to work as expected.

Gamerayers, 2022-04-19:
Is there any reason that it couldn't be ESPHome?  Are you saying the refresh rate of the ESPHome software runs to slow to grab it off of modbus or simply that the data would be too slow to Home Assistant.  It isn't like you are sending data and needing it in a time critical nature.  Even a couple seconds of delay isn't a big deal.

Thread 16 (2021-04-20):

Problem finding the right pins on the pcb

Warrior700, 2021-04-20:
Hello everybody,

I have a Balboa bp2100g3 board. Unfortunately, I'm not really sure which pins the RS485 transceiver A / B should be connected to. I have a picture of the circuit board, the connector is on the top right. I've found the physical link layer description and I am confused what the meaning is. "It is also recommended to put pin 3 on the return line of the connection device to reduce the common mode voltage." Is It really necessary?

How did you connect your transceiver? A schematic would be helpful.

Many thanks to all the developers of this project.

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

cribskip, 2021-04-20:
Nice picture :-)

Are you able to measure the voltages on the pins? One pair should show +11...15V. So you know GND and Supply.

The other pair shows fluctating low voltages (<3V) to ground. The higher is A, IIRC. Those are interchangeable if it does not work, don't worry. The other two pins are NOT interchangable!!!!

srasmond, 2021-04-21:
@Warrior700 I have the same board layout. I kept it really simple as well:
- I plugged in an ATX Molex Micro Fit Connector 4Pin cable (60cm) in to the J35 plug on the Balboa board (the 2nd 4 pin connector from the top on the right of your picture).
- On the other end of the Molex cable (where I cut off the other connector to have 4 loose wires) you usually have 2 black wires and a yellow and red wire.
- In my case, the 2 black wires where the data connection (A & B), yellow was GND and Red was my power supply.
- **This could differ for you! You definitely need to measure this!**
- I used the Earth cable of my spa to connect my meter's ground with a clamp and then checked DC voltages on each wire.
- GND (0V) and V (+/- 13V in my case) are the easiest to detect and can be attached to your step-down converter.
- A & B are lower voltage and close to each other, but you should see a tiny difference, with the higher VDC one being cable B ("_RS-485 B"_) (cable A should be little lower in VDC, but like cribskip mentioned, no worries if they are connected wrongly, you will get bad messages, but no electrical damage or what so ever, just switch them if necessary on your TTL To RS485 Adapter --> **but like it was mentioned by cribskip always leave GND and V alone!**).
- That's it. No other tricks or cables where used to connect the Balboa board to my custom board.

Warrior700, 2021-04-21:
Thanks for the detailed description, I have a Molex Micro Fit cable like you in stock, also with black, yellow and red. At the weekend I will measure the pins. At first I will only connect RX / TX. For testing, I can also connect the WEMOS via USB and supply the 3.3V + GND via breadboard to the TTL to RS485 pcb. This should be possible, right?

srasmond, 2021-04-21:
For flashing and testing if the ESP can be found on your network and communication is working I just connect the _WEMOS_ via USB.

For testing the Spa communication without supplying power from the Balboa board, yes, you could power your _TTL to RS485_ via the 3.3V and GND pins from the _WEMOS_ if its connected via USB.

If that is working, ideally, before moving on, I would also test it without powering the _WEMOS_ via USB, but for example by wiring everything up and connecting an other 5V power source, so you could test the output of the step-down converter (which should be 3.3V) and receive your MQTT messages.
I made my PCB so that I could easily plug in and out both the _TTL to RS485_ and _WEMOS_ boards.
That way I could also double check my output voltage from the converter when it's straightly connected to the Balboa board before endangering my components on the PCB.

Michael0yodi, 2021-05-19:
What are the expected voltages? I've read that it should be ~3volt on RS485 but this is my readings, am i good or do you think somethings is wrong?
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

cribskip, 2021-05-19:
Perfect, go for it. You identified supply and gnd. If you mix up rs485 a
and b just swap them

Michael ***@***.***> schrieb am Mi., 19. Mai 2021, 14:23:

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

flechaig, 2021-12-22:
In my experience, with a Balboa BP613G2, the pinout is exactly the same.

Thread 17 (2021-06-09):

no connection, no messages

pato-loco, 2021-06-09:
Hello everybody,

I am desperate about this project right now.

My config:
- BP2100 (Spatech)
- WEMOS D1 mini pro (including external antenna)
- ARCELI TTL To RS485 Adapter 485 Serial Port UART Level Converter Module 3.3V 5V
- LM2596 (set to 3.3V)

What happened until now:
- Adoption of version 0.34
- Adaptation to my environment (SSID, PWD, Broker, Brk_Login, Brk_pwd)
- no connection to the WLAN recognizable

Then change by me:
- //Serial.println("millis-Hrest ");
- // hardreset ();

Result:
- no hard reset
- MQTT client send a message to MQTT server if connected
=> WLAN probably has enough time to connect and the MQTT server receives a "connection" confirmation
- that's all

Problem:
It doesn't matter whether I connect the spa or not
(RX flashes when connected), I do not receive any messages via MQTT.
When entering http://my_ip/update I only get the option for OTA update. No login process.
The default website then shows "Not found: / config".

I am happy about any kind of support.

Thanks in advance!

pato-loco, 2021-06-09:
Hi Sascha,

thank you for your fast response. And thank you for your great work :-)

Mhh, from my sight of view I have done all things, what is wright down in the readme.
I´ve also crossed A and B from the Spa. No connection to Wifi (without passing the hardreset).

The Wifi-Client connects to Wifi if I commend out "//Serial.println("millis-Hrest ");"
So I think, the Wifi range is sufficient.

In one of the "Issue-comments" I read about, that I have to bring "all" GND to one point. What does it mean?
Should I also bring GND (-) from Spa-In (-) to a common point?

And is there a chance to "debug" the input signal from the spa to the serial console or to mqtt?

pato-loco, 2021-06-09:
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

pato-loco, 2021-06-09:
// https://github.com/ccutrer/balboa_worldwide_app/blob/master/doc/protocol.md
// Reference:https://github.com/ccutrer/balboa_worldwide_app/wiki

// Please install the needed dependencies:
// CircularBuffer
// PubSubClient

// TODO:
// HomeAssistant autodiscover - mostly done
// Configuration handling
// Proper states (rather than just ON/OFF)
// OTA update from Firebase
// Settings
// Implement Existing Client Request/Response
// Handle non-CTS Client IDs

// +12V RED
// GND  BLACK
// A    YELLOW
// B    WHITE
#include <LittleFS.h>
#include <ArduinoJson.h>
#include <ESP8266WiFi.h>
#include <CircularBuffer.h>
#include <ESP8266WebServer.h>   // Local WebServer used to serve the configuration portal
#include <ESP8266mDNS.h>
#include <ESP8266HTTPUpdateServer.h>
#include <ArduinoOTA.h>
#include <PubSubClient.h>       // MQTT client

#define VERSION "0.35_1"
const char* HOSTNAME = "hottube";
String WIFI_SSID = ":-)";
String WIFI_PASSWORD = ":-)";
String BROKER = "192.168.9.44";
String BROKER_LOGIN = "foo";
String BROKER_PASS = "bar";
#define AUTO_TX false //if your chip needs to pull D1 high/low set this to false
#define SAVE_CONN false //save the ip details above to local filesystem

#define STRON String("ON").c_str()
#define STROFF String("OFF").c_str()

//HomeAssistant autodiscover
#define HASSIO true

#define TX485 D1  //find a way to skip this
#define RLY1  D7
#define RLY2  D8

CircularBuffer<uint8_t, 35> Q_in;
CircularBuffer<uint8_t, 35> Q_out;

ESP8266WebServer httpServer(80);
ESP8266HTTPUpdateServer httpUpdater;

WiFiClient wifiClient;
PubSubClient mqtt(wifiClient);

extern uint8_t crc8();
extern void ID_request();
extern void ID_ack();
extern void rs485_send();

uint8_t x, i, j;

uint8_t last_state_crc = 0x00;
uint8_t send = 0x00;
uint8_t settemp = 0x00;
uint8_t id = 0x00;

unsigned long lastrx = 0;

char have_config = 0; //stages: 0-> want it; 1-> requested it; 2-> got it; 3-> further processed it
char have_faultlog = 0; //stages: 0-> want it; 1-> requested it; 2-> got it; 3-> further processed it
char faultlog_minutes = 0; //temp logic so we only get the fault log once per 5 minutes
char ip_settings = 0; //stages: 0-> want it; 1-> requested it; 2-> got it; 3-> further processed it

struct {
  uint8_t jet1 :1;
  uint8_t jet2 :1;
  uint8_t blower :1;
  uint8_t light :1;
  uint8_t restmode:1;
  uint8_t highrange:1;
  uint8_t padding :2;
  uint8_t hour :5;
  uint8_t minutes :6;
} SpaState;

struct {
  uint8_t pump1 :2; //this could be 1=1 speed; 2=2 speeds
  uint8_t pump2 :1;
  uint8_t pump3 :1;
  uint8_t pump4 :1;
  uint8_t pump5 :1;
  uint8_t pump6 :1;
  uint8_t light1 :1;
  uint8_t light2 :1;
  uint8_t circ :1;
  uint8_t blower :1;
  uint8_t mister :1;
  uint8_t aux1 :1;
  uint8_t aux2 :1;
} SpaConfig;

struct {
  uint8_t totEntry :5;
  uint8_t currEntry :5;
  uint8_t faultCode :6;
  String faultMessage;
  uint8_t daysAgo :8;
  uint8_t hour :5;
  uint8_t minutes :6;
} SpaFaultLog;

void _yield() {
  yield();
  mqtt.loop();
  httpServer.handleClient();
}

void print_msg(CircularBuffer<uint8_t, 35> &data) {
  String s;
  //for (i = 0; i < (Q_in[1] + 2); i++) {
  for (i = 0; i < data.size(); i++) {
    x = Q_in[i];
    if (x < 0x0A) s += "0";
    s += String(x, HEX);
    s += " ";
  }
  mqtt.publish("autohome/garden/hottube/node/msg", s.c_str());
  _yield();
}

void decodeFault() {
  SpaFaultLog.totEntry = Q_in[5];
  SpaFaultLog.currEntry = Q_in[6];
  SpaFaultLog.faultCode = Q_in[7];
  switch (SpaFaultLog.faultCode) { // this is a inelegant way to do it, a lookup table would be better
    case 15:
      SpaFaultLog.faultMessage = "Sensors are out of sync";
      break;
    case 16:
      SpaFaultLog.faultMessage = "The water flow is low";
      break;
    case 17:
      SpaFaultLog.faultMessage = "The water flow has failed";
      break;
    case 18:
      SpaFaultLog.faultMessage = "The settings have been reset";
      break;
    case 19:
      SpaFaultLog.faultMessage = "Priming Mode";
      break;
    case 20:
      SpaFaultLog.faultMessage = "The clock has failed";
      break;
    case 21:
      SpaFaultLog.faultMessage = "The settings have been reset";
      break;
    case 22:
      SpaFaultLog.faultMessage = "Program memory failure";
      break;
    case 26:
      SpaFaultLog.faultMessage = "Sensors are out of sync -- Call for service";
      break;
    case 27:
      SpaFaultLog.faultMessage = "The heater is dry";
      break;
    case 28:
      SpaFaultLog.faultMessage = "The heater may be dry";
      break;
    case 29:
      SpaFaultLog.faultMessage = "The water is too hot";
      break;
    case 30:
      SpaFaultLog.faultMessage = "The heater is too hot";
      break;
    case 31:
      SpaFaultLog.faultMessage = "Sensor A Fault";
      break;
    case 32:
      SpaFaultLog.faultMessage = "Sensor B Fault";
      break;
    case 34:
      SpaFaultLog.faultMessage = "A pump may be stuck on";
      break;
    case 35:
      SpaFaultLog.faultMessage = "Hot fault";
      break;
    case 36:
      SpaFaultLog.faultMessage = "The GFCI test failed";
      break;
    case 37:
      SpaFaultLog.faultMessage = "Standby Mode (Hold Mode)";
      break;
    default:
      SpaFaultLog.faultMessage = "Unknown error";
      break;
  }
  SpaFaultLog.daysAgo = Q_in[8];
  SpaFaultLog.hour = Q_in[9];
  SpaFaultLog.minutes = Q_in[10];
  mqtt.publish("autohome/garden/hottube/fault/Entries", String(SpaFaultLog.totEntry).c_str());
  mqtt.publish("autohome/garden/hottube/fault/Entry", String(SpaFaultLog.currEntry).c_str());
  mqtt.publish("autohome/garden/hottube/fault/Code", String(SpaFaultLog.faultCode).c_str());
  mqtt.publish("autohome/garden/hottube/fault/Message", SpaFaultLog.faultMessage.c_str());
  mqtt.publish("autohome/garden/hottube/fault/DaysAgo", String(SpaFaultLog.daysAgo).c_str());
  mqtt.publish("autohome/garden/hottube/fault/Hours", String(SpaFaultLog.hour).c_str());
  mqtt.publish("autohome/garden/hottube/fault/Minutes", String(SpaFaultLog.minutes).c_str());
  have_faultlog = 2;
}

void decodeSettings() {
  //mqtt.publish("autohome/garden/hottube/config/status", "Got config");
  SpaConfig.pump1 = Q_in[5] & 0x03;
  SpaConfig.pump2 = (Q_in[5] & 0x0C) >> 2;
  SpaConfig.pump3 = (Q_in[5] & 0x30) >> 4;
  SpaConfig.pump4 = (Q_in[5] & 0xC0) >> 6;
  SpaConfig.pump5 = (Q_in[6] & 0x03);
  SpaConfig.pump6 = (Q_in[6] & 0xC0) >> 6;
  SpaConfig.light1 = (Q_in[7] & 0x03);
  SpaConfig.light2 = (Q_in[7] >> 2) & 0x03;
  SpaConfig.circ = ((Q_in[8] & 0x80) != 0);
  SpaConfig.blower = ((Q_in[8] & 0x03) != 0);
  SpaConfig.mister = ((Q_in[9] & 0x30) != 0);
  SpaConfig.aux1 = ((Q_in[9] & 0x01) != 0);
  SpaConfig.aux2 = ((Q_in[9] & 0x02) != 0);
  mqtt.publish("autohome/garden/hottube/config/pumps1", String(SpaConfig.pump1).c_str());
  mqtt.publish("autohome/garden/hottube/config/pumps2", String(SpaConfig.pump2).c_str());
  mqtt.publish("autohome/garden/hottube/config/pumps3", String(SpaConfig.pump3).c_str());
  mqtt.publish("autohome/garden/hottube/config/pumps4", String(SpaConfig.pump4).c_str());
  mqtt.publish("autohome/garden/hottube/config/pumps5", String(SpaConfig.pump5).c_str());
  mqtt.publish("autohome/garden/hottube/config/pumps6", String(SpaConfig.pump6).c_str());
  mqtt.publish("autohome/garden/hottube/config/light1", String(SpaConfig.light1).c_str());
  mqtt.publish("autohome/garden/hottube/config/light2", String(SpaConfig.light2).c_str());
  mqtt.publish("autohome/garden/hottube/config/circ", String(SpaConfig.circ).c_str());
  mqtt.publish("autohome/garden/hottube/config/blower", String(SpaConfig.blower).c_str());
  mqtt.publish("autohome/garden/hottube/config/mister", String(SpaConfig.mister).c_str());
  mqtt.publish("autohome/garden/hottube/config/aux1", String(SpaConfig.aux1).c_str());
  mqtt.publish("autohome/garden/hottube/config/aux2", String(SpaConfig.aux2).c_str());
  have_config = 2;
}

void decodeState() {
  String s;
  double d = 0.0;
  double c = 0.0;

  // DEBUG for finding meaning:
  //print_msg(Q_in);

  // 25:Flag Byte 20 - Set Temperature
  d = Q_in[25] / 2;
  if (Q_in[25] % 2 == 1) d += 0.5;
  mqtt.publish("autohome/garden/hottube/target_temp/state", String(d, 2).c_str());

  // 7:Flag Byte 2 - Actual temperature
  if (Q_in[7] != 0xFF) {
    d = Q_in[7] / 2;
    if (Q_in[7] % 2 == 1) d += 0.5;
    if (c > 0) {
      if ((d > c * 1.2) || (d < c * 0.8)) d = c; //remove spurious readings greater or less than 20% away from previous read
    }

    mqtt.publish("autohome/garden/hottube/temperature/state", String(d, 2).c_str());
    c = d;
  } else {
    d = 0;
  }
  // REMARK Move upper publish to HERE to get 0 for unknown temperature

  // 8:Flag Byte 3 Hour & 9:Flag Byte 4 Minute => Time
  if (Q_in[8] < 10) s = "0"; else s = "";
  SpaState.hour = Q_in[8];
  s = String(Q_in[8]) + ":";
  if (Q_in[9] < 10) s += "0";
  s += String(Q_in[9]);
  SpaState.minutes = Q_in[9];
  mqtt.publish("autohome/garden/hottube/time/state", s.c_str());

  // 10:Flag Byte 5 - Heating Mode
  switch (Q_in[10]) {
    case 0:mqtt.publish("autohome/garden/hottube/heatingmode/state", STRON); //Ready
      mqtt.publish("autohome/garden/hottube/heat_mode/state", "heat"); //Ready
      SpaState.restmode = 0;
      break;
    case 3:// Ready-in-Rest
      SpaState.restmode = 0;
      break;
    case 1:mqtt.publish("autohome/garden/hottube/heatingmode/state", STROFF); //Rest
      mqtt.publish("autohome/garden/hottube/heat_mode/state", "off"); //Rest
      SpaState.restmode = 1;
      break;
  }

  // 15:Flags Byte 10 / Heat status, Temp Range
  d = bitRead(Q_in[15], 4);
  if (d == 0) mqtt.publish("autohome/garden/hottube/heatstate/state", STROFF);
  else if (d == 1 || d == 2) mqtt.publish("autohome/garden/hottube/heatstate/state", STRON);

  d = bitRead(Q_in[15], 2);
  if (d == 0) {
    mqtt.publish("autohome/garden/hottube/highrange/state", STROFF); //LOW
    SpaState.highrange = 0;
  } else if (d == 1) {
    mqtt.publish("autohome/garden/hottube/highrange/state", STRON); //HIGH
    SpaState.highrange = 1;
  }

  // 16:Flags Byte 11
  if (bitRead(Q_in[16], 1) == 1) {
    mqtt.publish("autohome/garden/hottube/jet_1/state", STRON);
    SpaState.jet1 = 1;
  } else {
    mqtt.publish("autohome/garden/hottube/jet_1/state", STROFF);
    SpaState.jet1 = 0;
  }

  if (bitRead(Q_in[16], 3) == 1) {
    mqtt.publish("autohome/garden/hottube/jet_2/state", STRON);
    SpaState.jet2 = 1;
  } else {
    mqtt.publish("autohome/garden/hottube/jet_2/state", STROFF);
    SpaState.jet2 = 0;
  }

  // 18:Flags Byte 13
  if (bitRead(Q_in[18], 1) == 1)
    mqtt.publish("autohome/garden/hottube/circ/state", STRON);
  else
    mqtt.publish("autohome/garden/hottube/circ/state", STROFF);

  if (bitRead(Q_in[18], 2) == 1) {
    mqtt.publish("autohome/garden/hottube/blower/state", STRON);
    SpaState.blower = 1;
  } else {
    mqtt.publish("autohome/garden/hottube/blower/state", STROFF);
    SpaState.blower = 0;
  }
  // 19:Flags Byte 14
  if (Q_in[19] == 0x03) {
    mqtt.publish("autohome/garden/hottube/light/state", STRON);
    SpaState.light = 1;
  } else {
    mqtt.publish("autohome/garden/hottube/light/state", STROFF);
    SpaState.light = 0;
  }

  last_state_crc = Q_in[Q_in[1]];

  // Publish own relay states
  s = "OFF";
  if (digitalRead(RLY1) == LOW) s = "ON";
  mqtt.publish("autohome/garden/hottube/relay_1/state", s.c_str());

  s = "OFF";
  if (digitalRead(RLY2) == LOW) s = "ON";
  mqtt.publish("autohome/garden/hottube/relay_2/state", s.c_str());
}

///////////////////////////////////////////////////////////////////////////////

void hardreset() {
  ESP.wdtDisable();
  while (1) {};
}

void mqttpubsub() {
  // ONLY DO THE FOLLOWING IF have_config == true otherwise it will not work
  String Payload;

  // ... Hassio autodiscover
  if (HASSIO) {

      //clear topics:
      mqtt.publish("homeassistant/binary_sensor/Spa", "");
      mqtt.publish("homeassistant/sensor/Spa", "");
      mqtt.publish("homeassistant/switch/Spa", "");
      mqtt.publish("/Spa", "");

      //temperature -> can we try and remove the Payload below, it's messy
      Payload = "{\"name\":\"Hot tub status\",\"uniq_id\":\"ESP82Spa_1\",\"stat_t\":\"autohome/garden/hottube/node/state\",\"platform\":\"mqtt\",\"dev\":{\"ids\":[\"ESP82Spa\"],\"name\":\"Esp Spa\",\"sw\":\""+String(VERSION)+"\"}}";
      mqtt.publish("homeassistant/binary_sensor/Spa/state/config", Payload.c_str());
      //temperature
      //mqtt.publish("homeassistant/sensor/Spa/temperature/config", "{\"name\":\"Hot tub temperature\",\"uniq_id\":\"ESP82Spa_2\",\"stat_t\":\"autohome/garden/hottube/temperature/state\",\"unit_of_meas\":\"°C\",\"platform\":\"mqtt\",\"dev\":{\"ids\":[\"ESP82Spa\"]}}");
      //target_temperature
      //mqtt.publish("homeassistant/switch/Spa/target_temp/config", "{\"name\":\"Hot tub target temperature\",\"cmd_t\":\"autohome/garden/hottube/target_temp/set\",\"stat_t\":\"autohome/garden/hottube/target_temp/state\",\"unit_of_measurement\":\"°C\"}");
      //climate temperature
      mqtt.publish("homeassistant/climate/Spa/temperature/config", "{\"name\":\"Hot tub thermostat\",\"uniq_id\":\"ESP82Spa_0\",\"temp_cmd_t\":\"autohome/garden/hottube/target_temp/set\",\"mode_cmd_t\":\"autohome/garden/hottube/heat_mode/set\",\"mode_stat_t\":\"autohome/garden/hottube/heat_mode/state\",\"curr_temp_t\":\"autohome/garden/hottube/temperature/state\",\"temp_stat_t\":\"autohome/garden/hottube/target_temp/state\",\"min_temp\":\"27\",\"max_temp\":\"40\",\"modes\":[\"off\", \"heat\"], \"temp_step\":\"0.5\",\"platform\":\"mqtt\",\"dev\":{\"ids\":[\"ESP82Spa\"]}}");
      //heat mode
      mqtt.publish("homeassistant/switch/Spa/heatingmode/config", "{\"name\":\"Hot tub heating mode\",\"uniq_id\":\"ESP82Spa_3\",\"cmd_t\":\"autohome/garden/hottube/heatingmode/set\",\"stat_t\":\"autohome/garden/hottube/heatingmode/state\",\"platform\":\"mqtt\",\"dev\":{\"ids\":[\"ESP82Spa\"]}}");
      //heating state
      mqtt.publish("homeassistant/binary_sensor/Spa/heatstate/config", "{\"name\":\"Hot tub heating state\",\"uniq_id\":\"ESP82Spa_6\",\"stat_t\":\"autohome/garden/hottube/heatstate/state\",\"platform\":\"mqtt\",\"dev\":{\"ids\":[\"ESP82Spa\"]}}");
      //high range
      mqtt.publish("homeassistant/switch/Spa/highrange/config", "{\"name\":\"Hot tub high range\",\"uniq_id\":\"ESP82Spa_4\",\"cmd_t\":\"autohome/garden/hottube/highrange/set\",\"stat_t\":\"autohome/garden/hottube/highrange/state\",\"platform\":\"mqtt\",\"dev\":{\"ids\":[\"ESP82Spa\"]}}");

      //OPTIONAL ELEMENTS
      if (SpaConfig.circ){
        //circulation pump
        mqtt.publish("homeassistant/binary_sensor/Spa/circ/config", "{\"name\":\"Hot tub circulation pump\",\"uniq_id\":\"ESP82Spa_5\",\"device_class\":\"power\",\"stat_t\":\"autohome/garden/hottube/circ/state\",\"platform\":\"mqtt\",\"dev\":{\"ids\":[\"ESP82Spa\"]}}");
      }
      if (SpaConfig.light1) {
        //light 1
        mqtt.publish("homeassistant/switch/Spa/light/config", "{\"name\":\"Hot tub light\",\"uniq_id\":\"ESP82Spa_7\",\"cmd_t\":\"autohome/garden/hottube/light/set\",\"stat_t\":\"autohome/garden/hottube/light/state\",\"platform\":\"mqtt\",\"dev\":{\"ids\":[\"ESP82Spa\"]}}");
      }
      if (SpaConfig.pump1 != 0) {
        //jets 1
        mqtt.publish("homeassistant/switch/Spa/jet_1/config", "{\"name\":\"Hot tub jet1\",\"uniq_id\":\"ESP82Spa_8\",\"cmd_t\":\"autohome/garden/hottube/jet_1/set\",\"stat_t\":\"autohome/garden/hottube/jet_1/state\",\"platform\":\"mqtt\",\"dev\":{\"ids\":[\"ESP82Spa\"]}}");
      }
      if (SpaConfig.pump2 != 0) {
        //jets 2
        mqtt.publish("homeassistant/switch/Spa/jet_2/config", "{\"name\":\"Hot tub jet2\",\"uniq_id\":\"ESP82Spa_9\",\"cmd_t\":\"autohome/garden/hottube/jet_2/set\",\"stat_t\":\"autohome/garden/hottube/jet_2/state\",\"platform\":\"mqtt\",\"dev\":{\"ids\":[\"ESP82Spa\"]}}");
      }
      if (SpaConfig.blower)
      {
        //blower
        mqtt.publish("homeassistant/switch/Spa/blower/config", "{\"name\":\"Hot tub blower\",\"uniq_id\":\"ESP82Spa_10\",\"cmd_t\":\"autohome/garden/hottube/blower/set\",\"stat_t\":\"autohome/garden/hottube/blower/state\",\"platform\":\"mqtt\",\"dev\":{\"ids\":[\"ESP82Spa\"]}}");
      }

  }

  mqtt.publish("autohome/garden/hottube/node/state", "ON");
  mqtt.publish("autohome/garden/hottube/node/debug", "RECONNECT");
  //mqtt.publish("autohome/garden/hottube/node/debug", String(millis()).c_str());
  //mqtt.publish("autohome/garden/hottube/node/debug", String(oldstate).c_str());
  mqtt.publish("autohome/garden/hottube/node/version", VERSION);
  mqtt.publish("autohome/garden/hottube/node/flashsize", String(ESP.getFlashChipRealSize()).c_str());
  mqtt.publish("autohome/garden/hottube/node/chipid", String(ESP.getChipId()).c_str());
	mqtt.publish("autohome/garden/hottube/node/speed", String(ESP.getCpuFreqMHz()).c_str());

  // ... and resubscribe
  mqtt.subscribe("autohome/garden/hottube/command");
  mqtt.subscribe("autohome/garden/hottube/target_temp/set");
  mqtt.subscribe("autohome/garden/hottube/heatingmode/set");
  mqtt.subscribe("autohome/garden/hottube/heat_mode/set");
  mqtt.subscribe("autohome/garden/hottube/highrange/set");

  //OPTIONAL ELEMENTS
  if (SpaConfig.pump1 != 0) {
    mqtt.subscribe("autohome/garden/hottube/jet_1/set");
  }
  if (SpaConfig.pump2 != 0) {
    mqtt.subscribe("autohome/garden/hottube/jet_2/set");
  }
  if (SpaConfig.blower) {
    mqtt.subscribe("autohome/garden/hottube/blower/set");
  }
  if (SpaConfig.light1) {
    mqtt.subscribe("autohome/garden/hottube/light/set");
  }

  mqtt.subscribe("autohome/garden/hottube/relay_1/set");
  mqtt.subscribe("autohome/garden/hottube/relay_2/set");

  //not sure what this is
  last_state_crc = 0x00;

  //done with config
  have_config = 3;
}

void reconnect() {
  //int oldstate = mqtt.state();
  //boolean connection = false;
  // Loop until we're reconnected
  if (!mqtt.connected()) {
    // Attempt to connect
    if (BROKER_PASS == "") {
      //connection =
      mqtt.connect(String(String(HOSTNAME) + String(millis())).c_str());
    }
    else {
      //connection =
      mqtt.connect(HOSTNAME, BROKER_LOGIN.c_str(), BROKER_PASS.c_str());
      mqtt.publish("autohome/garden/hottube/mqtt/status", "connected");
      Serial.println("mqtt connected");
    }

    if (have_config == 3) {
      have_config = 2; // we have disconnected, let's republish our configuration
    }

  }
  mqtt.setBufferSize(512); //increase pubsubclient buffer size
}

// function called when a MQTT message arrived
void callback(char* p_topic, byte * p_payload, unsigned int p_length) {
  // concat the payload into a string
  String payload;
  for (uint8_t i = 0; i < p_length; i++) {
    payload.concat((char)p_payload[i]);
  }
  String topic = String(p_topic);

  mqtt.publish("autohome/garden/hottube/node/debug", topic.c_str());
  _yield();

  // handle message topic
  if (topic.startsWith("autohome/garden/hottube/relay_")) {
    bool newstate = 0;

    if (payload.equals("ON")) newstate = LOW;
    else if (payload.equals("OFF")) newstate = HIGH;

    if (topic.charAt(10) == '1') {
      pinMode(RLY1, INPUT);
      delay(25);
      pinMode(RLY1, OUTPUT);
      digitalWrite(RLY1, newstate);
    }
    else if (topic.charAt(10) == '2') {
      pinMode(RLY2, INPUT);
      delay(25);
      pinMode(RLY2, OUTPUT);
      digitalWrite(RLY2, newstate);
    }
  } else if (topic.equals("autohome/garden/hottube/command")) {
    if (payload.equals("reset")) hardreset();
  } else if (topic.equals("autohome/garden/hottube/heatingmode/set")) {
    if (payload.equals("ON") && SpaState.restmode == 1) send = 0x51; // ON = Ready; OFF = Rest
    else if (payload.equals("OFF") && SpaState.restmode == 0) send = 0x51;
  } else if (topic.equals("autohome/garden/hottube/heat_mode/set")) {
    if (payload.equals("heat") && SpaState.restmode == 1) send = 0x51; // ON = Ready; OFF = Rest
    else if (payload.equals("off") && SpaState.restmode == 0) send = 0x51;
  } else if (topic.equals("autohome/garden/hottube/light/set")) {
    if (payload.equals("ON") && SpaState.light == 0) send = 0x11;
    else if (payload.equals("OFF") && SpaState.light == 1) send = 0x11;
  } else if (topic.equals("autohome/garden/hottube/jet_1/set")) {
    if (payload.equals("ON") && SpaState.jet1 == 0) send = 0x04;
    else if (payload.equals("OFF") && SpaState.jet1 == 1) send = 0x04;
  } else if (topic.equals("autohome/garden/hottube/jet_2/set")) {
    if (payload.equals("ON") && SpaState.jet2 == 0) send = 0x05;
    else if (payload.equals("OFF") && SpaState.jet2 == 1) send = 0x05;
  } else if (topic.equals("autohome/garden/hottube/blower/set")) {
    if (payload.equals("ON") && SpaState.blower == 0) send = 0x0C;
    else if (payload.equals("OFF") && SpaState.blower == 1) send = 0x0C;
  } else if (topic.equals("autohome/garden/hottube/highrange/set")) {
    if (payload.equals("ON") && SpaState.highrange == 0) send = 0x50; //ON = High, OFF = Low
    else if (payload.equals("OFF") && SpaState.highrange == 1) send = 0x50;
  } else if (topic.equals("autohome/garden/hottube/target_temp/set")) {
    // Get new set temperature
    double d = payload.toDouble();
    if (d > 0) d *= 2; // Convert to internal representation
    settemp = d;
    send = 0xff;
  }
}

///////////////////////////////////////////////////////////////////////////////

void setup() {
  DynamicJsonDocument jsonSettings(1024);
  //jsonSettings["WIFI_SSID"] = "";
  //jsonSettings["WIFI_PASSWORD"] = "";
  //jsonSettings["BROKER"] = "";
  //jsonSettings["BROKER_LOGIN"] = "";
  //jsonSettings["BROKER_PASS"] = "";

  String error_msg = "";

  //if (LittleFS.format()){

  if (LittleFS.begin()) {

  if (SAVE_CONN == true) {
    File f = LittleFS.open("/ip.txt", "w");
    if (!f) {
      error_msg = "failed to create file";
    }

    jsonSettings["WIFI_SSID"] = WIFI_SSID;
    jsonSettings["WIFI_PASSWORD"] = WIFI_PASSWORD;
    jsonSettings["BROKER"] = BROKER;
    jsonSettings["BROKER_LOGIN"] = BROKER_LOGIN;
    jsonSettings["BROKER_PASS"] = BROKER_PASS;

    if (serializeJson(jsonSettings, f) == 0) {
      error_msg = "failed to write file";
    }

    f.close();
  }

  jsonSettings["WIFI_SSID"] = "";
  jsonSettings["WIFI_PASSWORD"] = "";
  jsonSettings["BROKER"] = "";
  jsonSettings["BROKER_LOGIN"] = "";
  jsonSettings["BROKER_PASS"] = "";

  if (ip_settings == 0) {
    ip_settings = 1;
    //read the settings from filesystem, if empty, put in AP mode

    File file = LittleFS.open("/ip.txt", "r");
    if (!file) {
      error_msg = "could not open file for reading";
    } else {
      deserializeJson(jsonSettings, file);
      //Filesystem methods assuming it all went well

      //now I have them - NOTE: PROBABLY NEED TO CHECK THEM!!!!!
      ip_settings = 2;
      WIFI_SSID = jsonSettings["WIFI_SSID"].as<String>();
      WIFI_PASSWORD = jsonSettings["WIFI_PASSWORD"].as<String>();
      BROKER = jsonSettings["BROKER"].as<String>();
      BROKER_LOGIN = jsonSettings["BROKER_LOGIN"].as<String>();
      BROKER_PASS = jsonSettings["BROKER_PASS"].as<String>();
      error_msg = "Successfully read the configuration";
    }
    file.close();

  }
} else {
  error_msg = "Could not mount fs";
}
//} else {
//  error_msg = "count not format fs";
//}

  LittleFS.end();

  // Begin RS485 in listening mode -> no longer required with new RS485 chip
  if (AUTO_TX){

  } else {
    pinMode(TX485, OUTPUT);
    digitalWrite(TX485, LOW);
  }

  pinMode(RLY1, OUTPUT);
  digitalWrite(RLY1, HIGH);
  pinMode(RLY2, OUTPUT);
  digitalWrite(RLY2, HIGH);

  // Spa communication, 115.200 baud 8N1
  Serial.begin(115200);

  // give Spa time to wake up after POST
  for (uint8_t i = 0; i < 5; i++) {
    delay(1000);
    yield();
  }

  Q_in.clear();
  Q_out.clear();

  WiFi.setOutputPower(20.5); // this sets wifi to highest power
  WiFi.hostname(HOSTNAME);
  WiFi.begin(WIFI_SSID.c_str(), WIFI_PASSWORD.c_str());
  unsigned long timeout = millis() + 10000;
  Serial.println(WiFi.hostname());
  Serial.println(WiFi.localIP());

  while (WiFi.status() != WL_CONNECTED && millis() < timeout) {
    yield();
  }

  // Reset because of no connection
  if (WiFi.status() != WL_CONNECTED) {
    Serial.println("WiFi not connected. Restart");
    hardreset();
  }

  httpUpdater.setup(&httpServer, "admin", "");
  httpServer.begin();
  Serial.println("HttpServer started");
  MDNS.begin(HOSTNAME);
  MDNS.addService("http", "tcp", 80);

  mqtt.setServer(BROKER.c_str(), 1883);
  mqtt.setCallback(callback);
  mqtt.setKeepAlive(10);
  mqtt.setSocketTimeout(20);

  /*the below is for debug purposes
  mqtt.connect(HOSTNAME, BROKER_LOGIN.c_str(), BROKER_PASS.c_str());
  mqtt.publish("autohome/garden/hottube/debug/wifi_ssid", WIFI_SSID.c_str());
  mqtt.publish("autohome/garden/hottube/debug/wifi_password", WIFI_PASSWORD.c_str());
  mqtt.publish("autohome/garden/hottube/debug/broker", BROKER.c_str());
  mqtt.publish("autohome/garden/hottube/debug/broker_login", BROKER_LOGIN.c_str());
  mqtt.publish("autohome/garden/hottube/debug/broker_pass", BROKER_PASS.c_str());
  mqtt.publish("autohome/garden/hottube/debug/error", error_msg.c_str());
  */

}

void loop() {
  if (WiFi.status() != WL_CONNECTED) ESP.restart();
  if (!mqtt.connected()) reconnect();

  if (have_config == 2) mqttpubsub(); //do mqtt stuff after we're connected and if we have got the config elements
  //httpServer.handleClient(); needed?
  _yield();

  // Read from Spa RS485
  if (Serial.available()) {
    x = Serial.read();
    Q_in.push(x);
    mqtt.publish("autohome/garden/hottube/RS485/status", "connected");
    // Drop until SOF is seen
    if (Q_in.first() != 0x7E) Q_in.clear();
    lastrx = millis();
  }

  //Every x minutes, read the fault log using SpaState,minutes
  if (SpaState.minutes % 5 == 0) {
    //logic to only get the error message once -> this is dirty
    //have_faultlog = 0;
    if (have_faultlog == 2) { // we got the fault log before and treated it
      if (faultlog_minutes == SpaState.minutes) { // we got the fault log this interval so do nothing
      }
      else {
        faultlog_minutes = SpaState.minutes;
        have_faultlog = 0;
      }
    }
  }

  // DEBUG:mqtt.publish("autohome/garden/hottube/rcv", String(x).c_str()); _yield();

  // Double SOF-marker, drop last one
  if (Q_in[1] == 0x7E && Q_in.size() > 1) Q_in.pop();

  // Complete package
  //if (x == 0x7E && Q_in[0] == 0x7E && Q_in[1] != 0x7E) {
  if (x == 0x7E && Q_in.size() > 2) {
    //print_msg();

    // Unregistered or yet in progress
    if (id == 0) {
      if (Q_in[2] == 0xFE) print_msg(Q_in);

      // FE BF 02:got new client ID
      if (Q_in[2] == 0xFE && Q_in[4] == 0x02) {
        id = Q_in[5];
        if (id > 0x2F) id = 0x2F;

        ID_ack();
        mqtt.publish("autohome/garden/hottube/node/id", String(id).c_str());
      }

      // FE BF 00:Any new clients?
      if (Q_in[2] == 0xFE && Q_in[4] == 0x00) {
        ID_request();
      }
    } else if (Q_in[2] == id && Q_in[4] == 0x06) { // we have an ID, do clever stuff
        // id BF 06:Ready to Send
        if (send == 0xff) {
          // 0xff marks dirty temperature for now
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

Thread 18 (2021-06-10):

Strange Temperature Readings in HASS

reicharb, 2021-06-10:
My install seems to be working and I am getting data into HASS.  I see a couple issues maybe someone can help me with.
1. Strange Temp readings.  example: Spa says 92 deg F, HASS is showing 46 F.  I am sure it has to do with some kind of conversion.
2. Pump 1...My spa has a 2 speed pump.  During low speed HASS shows the pump off and it only shows on when the pump is in high speed.
3. During HASS reset, it show unavailable.  I have to cycle power on the 8266 and then the reading come in.

EmmanuelLM, 2021-07-08:
Hello.... let me have a look at issues 1 & 2 for you, I don't think any of us have a Farenheit reading nor 2 speed pump so this is a good case study :-)

On #1, I see that we divide the temperature in 2 for the Celcius, I will check where the Farenheit flag is
On #2, high speed is not (yet) supported - I will add that at the weekend, it seems easy enough, to help me debug, could you please send me the mqtt output for "Spa/config/*"?
On #3, I have the same annoyance, leave it with me

EmmanuelLM, 2021-07-10:
hmmm, second problem is a tad more problematic as high speed toggle is not documented... will have to dig into other people's code.
3 may be fixed (untested in my branch)

reicharb, 2021-07-10:
I was able to figure out #1, I did find the math function and made the change, it now reads Fahrenheit.
I also figured out #2, I created a low speed pump status.
#3 still seems to be a problem, a little work around I created a HASS automation that drops the 8266 from the Unifi wifi and waits for 2 minutes to allow it to connect to the network again.  I believe it forces it to hard reset itself.

EmmanuelLM, 2021-07-10:
Amazing, would you mind sending a pull request against my branch?

EmmanuelLM, 2021-07-11:
Hey, could you try v0.37.3 from here: https://github.com/EmmanuelLM/esp8266_spa
This has a fix for your first problem, I'll work on the second one - I am curious how you fixed it? I was thinking about using the new 'Select' configurator from Home-Assistant

EmmanuelLM, 2021-07-11:
Issue 3 should be fixed as well

Gamerayers, 2022-04-22:
I believe I have similar issues as this.  I'm super happy that I'm finally able to communicate with the spa using the ESP board, but things aren't working exactly as I expect, and I believe it is a different in models.
1. As you can see from the screenshot and mqtt messages, my spa is set for 115 and is not heating, but the image of the control panel says my spa is heating and set for 93 with a current temp of 92.
2. I have 2 control buttons for jets (the Jet button and the Aux button).  The jet button allows for 2 speeds, but the controls for hot tub jet1 and jet2 don't seem to allow for that control actually.
3. Heating mode was on/high range on when I first turn on the spa, but if I turn if off from the Home assistant, it does nothing and doesn't come back on when I turn it on again from Home Assistant.  I have no ability to really control this from the control panel.
The LED lights sort of control properly and do register when I turn them on from the control panel.

I'm guessing this is all due to my spa version/control panel version, but not sure how to make adjustments to make it work correctly.

`{"name":"Hot tub heating mode","uniq_id":"ESP82Spa_3","cmd_t":"Spa/heatingmode/set","stat_t":"Spa/heatingmode/state","platform":"mqtt","dev":{"ids":["ESP82Spa"]}}
{"name":"Hot tub high range","uniq_id":"ESP82Spa_4","cmd_t":"Spa/highrange/set","stat_t":"Spa/highrange/state","platform":"mqtt","dev":{"ids":["ESP82Spa"]}}
{"name":"Hot tub light","uniq_id":"ESP82Spa_7","cmd_t":"Spa/light/set","stat_t":"Spa/light/state","platform":"mqtt","dev":{"ids":["ESP82Spa"]}}
{"name":"Hot tub jet1","uniq_id":"ESP82Spa_8","cmd_t":"Spa/jet_1/set","stat_t":"Spa/jet_1/state","platform":"mqtt","dev":{"ids":["ESP82Spa"]}}
{"name":"Hot tub jet2","uniq_id":"ESP82Spa_9","cmd_t":"Spa/jet_2/set","stat_t":"Spa/jet_2/state","platform":"mqtt","dev":{"ids":["ESP82Spa"]}}
{"name":"Filter 1 start","val_tpl": "{{value_json.start}}","uniq_id":"ESP82Spa_11","stat_t":"Spa/filter1/state","platform":"mqtt","dev":{"ids":["ESP82Spa"]}}
{"name":"Filter 2 start","val_tpl": "{{value_json.start}}","uniq_id":"ESP82Spa_12","stat_t":"Spa/filter2/state","platform":"mqtt","dev":{"ids":["ESP82Spa"]}}
{"name":"Filter 1 duration","val_tpl": "{{value_json.duration}}","uniq_id":"ESP82Spa_13","stat_t":"Spa/filter1/state","platform":"mqtt","dev":{"ids":["ESP82Spa"]}}
{"name":"Filter 2 duration","val_tpl": "{{value_json.duration}}","uniq_id":"ESP82Spa_14","stat_t":"Spa/filter2/state","platform":"mqtt","dev":{"ids":["ESP82Spa"]}}
{"name":"Hot tub status","uniq_id":"ESP82Spa_1","stat_t":"Spa/node/state","platform":"mqtt","dev":{"ids":["ESP82Spa"],"name":"Esp Spa","sw":"0.37.4"}}
{"name":"Hot tub heating state","uniq_id":"ESP82Spa_6","stat_t":"Spa/heatstate/state","platform":"mqtt","dev":{"ids":["ESP82Spa"]}}
{"name":"Filter 2 enabled","uniq_id":"ESP82Spa_15","stat_t":"Spa/filter2_enabled/state","platform":"mqtt","dev":{"ids":["ESP82Spa"]}}
{"name":"Hot tub thermostat","uniq_id":"ESP82Spa_0","temp_cmd_t":"Spa/target_temp/set","mode_cmd_t":"Spa/heat_mode/set","mode_stat_t":"Spa/heat_mode/state","temp_unit": "C","curr_temp_t":"Spa/temperature/state","temp_stat_t":"Spa/target_temp/state","min_temp":"27","max_temp":"40","modes":["off", "heat"], "temp_step":"0.5","platform":"mqtt","dev":{"ids":["ESP82Spa"]}}`

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

Thread 19 (2021-08-01):

Short status messages. Results inaccurate.

rtsam, 2021-08-01:
Noticed we are getting incorrect statuses every hour or so. Seems to be a result of the status message being shorter than normal and skewing the data.

Spa/node/msg 7e 20 ff af 13 00 00 ff d 29 00 00 67 67 00 04 00 00 00 00 00 00 00 00 00 66 00 00 00 78 00 00 9e 7e
Spa/target_temp/state 102.00
Spa/time/state 13:41
Spa/heatingmode/state ON
Spa/heat_mode/state heat
Spa/heatstate/state OFF
Spa/highrange/state ON
Spa/jet_1/state OFF
Spa/jet_2/state OFF
Spa/circ/state OFF
Spa/blower/state OFF
Spa/light/state OFF
Spa/relay_1/state OFF
Spa/relay_2/state ON
Spa/node/msg 7e 20 ff af 13 00 00 ff d 29 00 00 67 67 f0 fe fe fc 01 00 00 66 00 00 00 78 00 00 9e 7e
Spa/target_temp/state 120.00
Spa/time/state 13:41
Spa/heatingmode/state ON
Spa/heat_mode/state heat
Spa/heatstate/state ON
Spa/highrange/state ON
Spa/jet_1/state ON
Spa/jet_2/state ON
Spa/circ/state OFF
Spa/blower/state OFF
Spa/light/state OFF
Spa/relay_1/state OFF
Spa/relay_2/state ON
Spa/node/msg 7e 20 ff af 13 00 00 ff d 29 00 00 67 67 00 04 00 00 00 00 00 00 00 00 00 66 00 00 00 78 00 00 9e 7e
Spa/target_temp/state 102.00
Spa/time/state 13:41
Spa/heatingmode/state ON
Spa/heat_mode/state heat
Spa/heatstate/state OFF
Spa/highrange/state ON
Spa/jet_1/state OFF
Spa/jet_2/state OFF
Spa/circ/state OFF
Spa/blower/state OFF
Spa/light/state OFF
Spa/relay_1/state OFF
Spa/relay_2/state ON
Spa/node/msg 7e 20 ff af 13 00 00 ff d 2a 00 00 67 67 00 04 00 00 00 00 00 00 00 00 00 66 00 00 00 78 00 00 52 7e
Spa/target_temp/state 102.00
Spa/time/state 13:42
Spa/heatingmode/state ON
Spa/heat_mode/state heat
Spa/heatstate/state OFF
Spa/highrange/state ON
Spa/jet_1/state OFF
Spa/jet_2/state OFF
Spa/circ/state OFF
Spa/blower/state OFF
Spa/light/state OFF
Spa/relay_1/state OFF
Spa/relay_2/state ON

Thread 21 (2021-11-11):

i need some help. but not for what you think.

tonyfitzs, 2021-11-11:
Hi there,
I am reaching out the my fellow Balboa Spa controller owners because I need some help with something. This is not really related to the ESP8266 client. Its more about the controller its self.
A few days ago one of the pumps in my spa took a power spik that fused the motor. This also caused a huge current spike that resulted in an arc at the point where the power goes into the controller.
I’m confident the controller is still able to be repaired, one thing that is great about the Balboa controller is they are almost bullet proof. Mind you I have never tried to shoot it, although I have been tempted.
Anyway, I have a Balboa Revolution controller (BP1600) and I need to either get a copy of a circuit diagram or else just a picture of the board where the neutral power goes into the controller. I have attached a couple of photos of what I am talking about, I need to know if the neutral line or the active line connects to U11, as you can imaging this is a very significant difference.

Thanks in advance, and sorry for the off-topic request, but I have run out of other options.

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

flechaig, 2021-11-15:
I think you can find the scheme in the technical datasheets on their website :
https://www.balboawatergroup.com/Technical-Data-Sheets

Thread 24 (2022-03-10):

Lost entities after HA reboot

pengemetal, 2022-03-10:
Hi,
If I restart Home Assistant, all entities set unavailabe. Mqtt is connected, I can see published data via MQTT.explorer. When I restart the spa with circuitbreaker everything will be ok. What is the problem? How can I restart esp via mqtt? Or why can not see HA autodiscovery after reboot? THX

Thread 25 (2022-04-13):

URL for webserver and other stuff

tonyfitzs, 2022-04-13:
Hi there,
I have spent many hours trying to get this to work, and I just can’t work it out. At least not without some more information. So I have a couple of questions.

1.	It indicates in the code that there should be a web server for configuration, is there a URL endpoint? Or is it just the ip address of the d1 mini?
2.	Does the circuit need to be connected to the spa before the webserver will start?
3.	Does the circuit need to be connected to the spa before the MQTT will start?
4.	Is there a web enabled terminal screen for de-bugging?
5.	I am seeing the following message in the terminal when the D1 mini is plugged into usb, where is this getting derived from?
ets Jan  8 2013,rst cause:4, boot mode:(3,7)
wdt reset
load 0x4010f000, len 3460, room 16
tail 4
chksum 0xcc
load 0x3fff20b8, len 40, room 4
tail 4
chksum 0xc9
csum 0xc9
v0005fc00
~ld

6.	Is it possible to get the URL for the web server added to this message to make it easier to find.

mopac, 2022-04-18:
Hi,
Looks like a watchdog reset.
The last few lines of the sketch show if a valid message has not been received in 10 seconds, the device will reset.
So if you are just connected to USB and not the hot tub, you would expect a reset every 10 seconds.
You can fix this because there is a #define called 'PRODUCTION'. If you set that to false, the watchdog reset won't occur and you might be able to connect to the web server.
Ray

Thread 26 (2022-04-18):

WEMOS D1 Mini Pro clone - not working

mopac, 2022-04-18:
Seems the genuine D1 mini pro is in short supply, so I had to buy a clone!
The problem is the clone uses CH340 for the USB to Serial whereas the original uses the CP2104. It also has no series resistor in the Rx path.
CH340 when the USB is not connected drives the RX pin low. This blocks all serial traffic from the hottub.

The solution I came up with was to use SoftwareSerial on pin 4 & 5, connected to the RS485 converted.
Running Software Serial at 115200 baud is at its limit, but it works with only a few errors every minute. These are normally quickly overwritten by correct data.
Maybe I'll add better data checking so these errors don't get passed to MQTT.

Has anyone else had problems with clones?
Any other the solutions than SoftwareSerial?

Ray

Gamerayers, 2022-04-19:
How were you able to find out that software serial was the fix.
I've been trying to figure out why my device isn't getting connected to MQTT, but I know that it needs to communicate to the spa first (btw, this is ridiculous for troubleshooting issues).
I see it connect to the wifi briefly, and I also see the blue LED flash, but nothing else.
This is the D1 Mini Pro I have.
https://www.amazon.com/gp/product/B08HH96RJY/ref=ppx_yo_dt_b_asin_title_o06_s00?ie=UTF8&psc=1
This is the adapter I have for communicating with RS485.
https://www.amazon.com/gp/product/B08XLT21S6/ref=ppx_yo_dt_b_asin_title_o09_s01?ie=UTF8&psc=1

Any help would be greatly appreciated.  I have a step down converter to 3.3V and it works.  And so far, no issues where the screen is blanks, so I assume the pins are connected correctly, but no data.

Gamerayers, 2022-04-19:
Just a quick update, it is definitely the communication with the spa over rs485 that is the issue, but the problem is how to determine if its the D1 Mini Pro clone that is the issue.  I'm able to see it connect and disconnect from my mqtt server, so it isn't the wifi or the mqtt, but it never sends anything.
So what changes to the code are needed to make this work/what other things do I need to do to accomplish the change.

Honestly, the errors every couple minutes are a pain, but if I can at least get that far, maybe I can get a genuine D1 at some point to fix it.

mopac, 2022-04-19:
Line 48 in the code
#define PRODUCTION true
change that to
#define PRODUCTION false
Then you don't get resets about every 30 seconds. So it should stay connected to MQTT broker.
Then publish debug info to MQTT and see what it is doing.
Or connect the USB cable to your laptop and publish debug info to Serial.
Line 867 is the start of the loop to get serial bytes from the hottub. You can add a print statement in there to see what is arriving.
It should be a long series of bytes starting and ending with 0x7E - maybe 25 bytes long.

My problem was the Rx pin was permanently low when no USB was attached; but was wiggling when it was attached.

mopac, 2022-04-20:
I came up with an even better solution that I think fixes most of the issues with getting these boards to work!
The fundamental problem is that ESP8266 only has one usable UART and that must be shared between USB serial and RS485 serial to the hottub.
But the ESP8266 has the ability to route the UART away from pins 1 & 3 (where the USB to Serial is connected), to pins 13 & 15.
My board has the RS485 converter connected to pins 13 & 15 and the WEMOS D1 Mini Pro has the USB to Serial connected to pins 1 & 3.
So now the the two sets of serial pins are completely separate.
So I switch the hardware UART to pins 13 & 15 and  use SoftwareSerial library for the USB on pins 1 & 3
Code:
  // Using hardware Serial for RS485 and software Serial for USB
  Serial.begin(115200);
  Serial.swap(); // Switch Hardware Serial to GPIO13 & GPIO15

  swSer1.begin(115200,SWSERIAL_8N1, 3, 1, false); // Start software serial
  swSer1.enableIntTx(false); // This is needed with high baudrates

  if (!swSer1) { // If the object did not initialize, then its configuration is invalid
      Serial.swap(); //Switch the Serial back to 1 & 3
      Serial.println("");
      Serial.println("Invalid SoftwareSerial pin configuration, check config");
  }
  else {
      swSer1.println("");
     swSer1.println("Correct SoftwareSerial pin configuration. Using Software Serial for USB");
  }

Then all the Serial.print statements in the rest of the code need to use swSer1.print.

Working really well with no errors from the Hottub and no obvious errors in the debug printing

Gamerayers, 2022-04-22:
So after much troubleshooting, and wasted time, the issue is simply that the designer of the RS485 board is not an electrical engineer, and doesn't practice standards.  And I guess I can't read.
Who makes black power and red ground.
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

sdrshnptl, 2024-02-20:
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

Thank you!
First thing I did this!

cribskip, 2024-02-20:
Thank you for posting the solution to this. Is your SPA connection now working?

Thread 27 (2022-04-20):

Bench Testing

mopac, 2022-04-20:
I find that the biggest problem with getting this project to work is configuring the UART to send and receive data via the RS485 converter. And you always seem to end up fiddling with things, bend double, outside on the ground with the HotTub taken apart.
But RS485 is a half duplex interface - the transmit and receive use the same pins.
So you receive whatever you send. This means you can fool the software into thinking you are connected to the Hottub just by sending the right message.
So I added a little test feature that sends an ID Command packet with ID = 0 every 3 seconds.
If everything is working, the software will respond with an ID ACK message.
This all runs on the bench inside where you have your logic analyser and oscilloscope.
So if you can get the ID ACK working on the bench, when you get in outside in the Hottub, the only thing left that can be wrong, is the RS485 wires might need swapping around.

My test function looks like this:
void spa_emulate() {
  Q_out.push(0xFE);
  Q_out.push(0xBF);
  Q_out.push(0x02);
  Q_out.push(0x00);

  rs485_send(true);
}

Call it every 3 seconds in the loop function (Don't forget to remove it when you connect to the Hottub)

Thread 28 (2022-04-25):

Helping editing code so that I can simply publish data to MQTT

Gamerayers, 2022-04-25:
After I finally got it hooked up to my hot tub on Friday, I've been trying to figure out how to understand why the data is all incorrect.
The temperature is really bad, but ultimately, I want to publish the entire read data, all the flags, from the spa to 1 or 2 MQTT messages.  What's the easiest way to do this.
I'm guessing, based on reading the information on the wiki, that my hot tub is using differen bits for most things on here.  My Jet has 2 speeds, but the jets on here is only 1.  My aux controls a jet, but there are 2 controls for jets on here which are different.  My thinking is go through, figure out why the data is all off.  Once I have the correct data, I can realign the signals and publish it correctly.

I guess where I'm most confused at this point is this line of code:   if (bitRead(Q_in[18], 1) == 1).
Why is Q_in[18] byte 13?

It seems like both the developers working on this maybe aren't working on anything on github since Oct 2021.  It would be helpful is anybody has some insight on to how to make this work for my specific spa.  I know I'm really close, but getting the exact right parameters maybe is the hardest part.  I am concerned that the temperature is off by so much though.

cribskip, 2022-04-25:
Hey,

thank you for opening the issue. I've not neglegted the project - rather, I'm glad to enjoy it working ;-)

So your tub is completely different than mine in its configuration. I think we can work this out. Please post as many details of the controller you can get hold of (control unit, controller...) for others to find this quicker.

Your first step should be to remove the comment slashes in this line:
https://github.com/cribskip/esp8266_spa/blob/015e468864a35a08b53799d69ec0e647002d2343/src/esp8266_spa.ino#L865

Then you get on Spa/rcv the received data stream. Then we can check if the messages are the same format.

Additionally, you referenced
https://github.com/cribskip/esp8266_spa/blob/015e468864a35a08b53799d69ec0e647002d2343/src/esp8266_spa.ino#L418

Those comments before each block helped me to keep in sync with the wiki. It simply means: Q_in[18] holds byte 13 of the wiki documented message. Wiki documentation simply used an offset to my implementation and I didn't want to drop bytes just to make it fit.

HTH
Sascha

Gamerayers, 2022-04-26:
Hi Sascha,

Thanks for the reply.  I've made some progress, but definitely some odd things.  I had to swap out the board since the previous one must have been shocked or something and can't be updated by USB and stopped communicated.  No biggy because the different board is acting a little different.
Looking at the below, it appears that the temp is correct, but maybe is being scaled to F even though it is already in F.  93 is what my spa is set to in F, but Home Assistant now says it is 199.  The Jet_1 and Jet_2 appear to be correct now.  Light is also correct, but when I try to command them from the Home Assistant, it doesn't do anything.
RCV goes through a number of values, but it moves too quickly.  I've posted a graph below.
Highrange, heat state, heat_mode, blow and circ aren't really options on my spa, so might be part of it.  I also can't enable heatingmode on the hot tub, so not sure if this is something simply that should be a sensor instead of a switch for my tub.
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

Info about my hot tub.  Its a 2020 Master Spa.  Clarity Series Balance 7.  Here's some images.
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

cribskip, 2022-04-26:
Spa/rcv contains the instantly received bytes and is very fast for human eye :-)
Please consider viewing it with a MQTT Client capable of displaying the history (e.g. mosquitto-sub on Linux).

Really seems to do C to F conversion twice. Maybe you're the first user with imperial units. Welcome :-D We may fix this with a compile time define-switch for now.

Did you see Spa/config messages? If now, this may cause the conversation problem:
https://github.com/cribskip/esp8266_spa/blob/015e468864a35a08b53799d69ec0e647002d2343/src/esp8266_spa.ino#L307

I'd really like to view one or two complete messages from your tub using the rcv message channel. Just to get to know your controller better and decide on the way to go.

Cheers,
Sascha

Gamerayers, 2022-04-26:
I don't seem to see the config message.  Simply doesn't ever seem to populate.  So I'm guessing that is part of the issue with the temperature. (image below)

As the messages doesn't seem to repeat exactly, I am not sure where the start of the rcv message and the end is.  So I logged it for a little bit.
<html xmlns:v="urn:schemas-microsoft-com:vml"
xmlns:o="urn:schemas-microsoft-com:office:office"
xmlns:x="urn:schemas-microsoft-com:office:excel"
xmlns="http://www.w3.org/TR/REC-html40">

<head>

<meta name=ProgId content=Excel.Sheet>
<meta name=Generator content="Microsoft Excel 15">
<link id=Main-File rel=Main-File
href="file:///C:/Users/brian/AppData/Local/Temp/msohtmlclip1/01/clip.htm">
<link rel=File-List
href="file:///C:/Users/brian/AppData/Local/Temp/msohtmlclip1/01/clip_filelist.xml">
<style>
<!--table
	{mso-displayed-decimal-separator:"\.";
	mso-displayed-thousand-separator:"\,";}
@page
	{margin:.75in .7in .75in .7in;
	mso-header-margin:.3in;
	mso-footer-margin:.3in;}
tr
	{mso-height-source:auto;}
col
	{mso-width-source:auto;}
br
	{mso-data-placement:same-cell;}
td
	{padding-top:1px;
	padding-right:1px;
	padding-left:1px;
	mso-ignore:padding;
	color:black;
	font-size:11.0pt;
	font-weight:400;
	font-style:normal;
	text-decoration:none;
	font-family:Calibri, sans-serif;
	mso-font-charset:0;
	mso-number-format:General;
	text-align:general;
	vertical-align:bottom;
	border:none;
	mso-background-source:auto;
	mso-pattern:auto;
	mso-protection:locked visible;
	white-space:nowrap;
	mso-rotate:0;}
-->
</style>
</head>

<body link="#0563C1" vlink="#954F72">

Topic: Spa/rcvQoS:   0 | 17 | 2022-04-26 13:55:45:277
-- | -- | --
Topic: Spa/rcvQoS: 0 | 0 | 2022-04-26 13:55:45:277
Topic: Spa/rcvQoS: 0 | 62 | 2022-04-26 13:55:45:278
Topic: Spa/rcvQoS: 0 | 126 | 2022-04-26 13:55:45:278
Topic: Spa/rcvQoS: 0 | 5 | 2022-04-26 13:55:45:278
Topic: Spa/rcvQoS: 0 | 16 | 2022-04-26 13:55:45:278
Topic: Spa/rcvQoS: 0 | 191 | 2022-04-26 13:55:45:279
Topic: Spa/rcvQoS: 0 | 6 | 2022-04-26 13:55:45:279
Topic: Spa/rcvQoS: 0 | 126 | 2022-04-26 13:55:45:279
Topic: Spa/rcvQoS: 0 | 92 | 2022-04-26 13:55:45:279
Topic: Spa/rcvQoS: 0 | 7 | 2022-04-26 13:55:45:280
Topic: Spa/rcvQoS: 0 | 16 | 2022-04-26 13:55:45:280
Topic: Spa/rcvQoS: 0 | 17 | 2022-04-26 13:55:45:280
Topic: Spa/rcvQoS: 0 | 0 | 2022-04-26 13:55:45:280
Topic: Spa/rcvQoS: 0 | 191 | 2022-04-26 13:55:45:280
Topic: Spa/rcvQoS: 0 | 0 | 2022-04-26 13:55:45:281
Topic: Spa/rcvQoS: 0 | 62 | 2022-04-26 13:55:45:281
Topic: Spa/rcvQoS: 0 | 126 | 2022-04-26 13:55:45:281
Topic: Spa/rcvQoS: 0 | 5 | 2022-04-26 13:55:45:282
Topic: Spa/rcvQoS: 0 | 191 | 2022-04-26 13:55:45:282
Topic: Spa/rcvQoS: 0 | 6 | 2022-04-26 13:55:45:282
Topic: Spa/rcvQoS: 0 | 92 | 2022-04-26 13:55:45:282
Topic: Spa/rcvQoS: 0 | 16 | 2022-04-26 13:55:45:282
Topic: Spa/rcvQoS: 0 | 126 | 2022-04-26 13:55:45:283
Topic: Spa/rcvQoS: 0 | 7 | 2022-04-26 13:55:45:283
Topic: Spa/rcvQoS: 0 | 16 | 2022-04-26 13:55:45:283
Topic: Spa/rcvQoS: 0 | 191 | 2022-04-26 13:55:45:283
Topic: Spa/rcvQoS: 0 | 17 | 2022-04-26 13:55:45:284
Topic: Spa/rcvQoS: 0 | 0 | 2022-04-26 13:55:45:284
Topic: Spa/rcvQoS: 0 | 62 | 2022-04-26 13:55:45:284
Topic: Spa/rcvQoS: 0 | 126 | 2022-04-26 13:55:45:285
Topic: Spa/rcvQoS: 0 | 5 | 2022-04-26 13:55:45:285
Topic: Spa/rcvQoS: 0 | 191 | 2022-04-26 13:55:45:285
Topic: Spa/rcvQoS: 0 | 16 | 2022-04-26 13:55:45:285
Topic: Spa/rcvQoS: 0 | 126 | 2022-04-26 13:55:45:286
Topic: Spa/rcvQoS: 0 | 7 | 2022-04-26 13:55:45:286
Topic: Spa/rcvQoS: 0 | 92 | 2022-04-26 13:55:45:286
Topic: Spa/rcvQoS: 0 | 6 | 2022-04-26 13:55:45:286
Topic: Spa/rcvQoS: 0 | 16 | 2022-04-26 13:55:45:287
Topic: Spa/rcvQoS: 0 | 191 | 2022-04-26 13:55:45:287
Topic: Spa/rcvQoS: 0 | 17 | 2022-04-26 13:55:45:287
Topic: Spa/rcvQoS: 0 | 0 | 2022-04-26 13:55:45:287
Topic: Spa/rcvQoS: 0 | 126 | 2022-04-26 13:55:45:288
Topic: Spa/rcvQoS: 0 | 5 | 2022-04-26 13:55:45:288
Topic: Spa/rcvQoS: 0 | 16 | 2022-04-26 13:55:45:288
Topic: Spa/rcvQoS: 0 | 62 | 2022-04-26 13:55:45:288
Topic: Spa/rcvQoS: 0 | 191 | 2022-04-26 13:55:45:289
Topic: Spa/rcvQoS: 0 | 6 | 2022-04-26 13:55:45:289
Topic: Spa/rcvQoS: 0 | 92 | 2022-04-26 13:55:45:289
Topic: Spa/rcvQoS: 0 | 126 | 2022-04-26 13:55:45:289
Topic: Spa/rcvQoS: 0 | 7 | 2022-04-26 13:55:45:290
Topic: Spa/rcvQoS: 0 | 16 | 2022-04-26 13:55:45:290
Topic: Spa/rcvQoS: 0 | 191 | 2022-04-26 13:55:45:290
Topic: Spa/rcvQoS: 0 | 17 | 2022-04-26 13:55:45:290
Topic: Spa/rcvQoS: 0 | 0 | 2022-04-26 13:55:45:291
Topic: Spa/rcvQoS: 0 | 62 | 2022-04-26 13:55:45:291
Topic: Spa/rcvQoS: 0 | 126 | 2022-04-26 13:55:45:291
Topic: Spa/rcvQoS: 0 | 126 | 2022-04-26 13:55:45:292
Topic: Spa/rcvQoS: 0 | 5 | 2022-04-26 13:55:45:292
Topic: Spa/rcvQoS: 0 | 16 | 2022-04-26 13:55:45:292
Topic: Spa/rcvQoS: 0 | 191 | 2022-04-26 13:55:45:292
Topic: Spa/rcvQoS: 0 | 92 | 2022-04-26 13:55:45:292
Topic: Spa/rcvQoS: 0 | 6 | 2022-04-26 13:55:45:292
Topic: Spa/rcvQoS: 0 | 126 | 2022-04-26 13:55:45:293
Topic: Spa/rcvQoS: 0 | 7 | 2022-04-26 13:55:45:293
Topic: Spa/rcvQoS: 0 | 16 | 2022-04-26 13:55:45:293
Topic: Spa/rcvQoS: 0 | 191 | 2022-04-26 13:55:45:294
Topic: Spa/rcvQoS: 0 | 17 | 2022-04-26 13:55:45:294
Topic: Spa/rcvQoS: 0 | 0 | 2022-04-26 13:55:45:294
Topic: Spa/rcvQoS: 0 | 62 | 2022-04-26 13:55:45:295
Topic: Spa/rcvQoS: 0 | 126 | 2022-04-26 13:55:45:295
Topic: Spa/rcvQoS: 0 | 5 | 2022-04-26 13:55:45:295
Topic: Spa/rcvQoS: 0 | 16 | 2022-04-26 13:55:45:295
Topic: Spa/rcvQoS: 0 | 191 | 2022-04-26 13:55:45:296
Topic: Spa/rcvQoS: 0 | 6 | 2022-04-26 13:55:45:296
Topic: Spa/rcvQoS: 0 | 92 | 2022-04-26 13:55:45:296
Topic: Spa/rcvQoS: 0 | 126 | 2022-04-26 13:55:45:296
Topic: Spa/rcvQoS: 0 | 7 | 2022-04-26 13:55:45:297
Topic: Spa/rcvQoS: 0 | 16 | 2022-04-26 13:55:45:297
Topic: Spa/rcvQoS: 0 | 191 | 2022-04-26 13:55:45:297
Topic: Spa/rcvQoS: 0 | 17 | 2022-04-26 13:55:45:297
Topic: Spa/rcvQoS: 0 | 0 | 2022-04-26 13:55:45:297
Topic: Spa/rcvQoS: 0 | 0 | 2022-04-26 13:55:45:298
Topic: Spa/rcvQoS: 0 | 62 | 2022-04-26 13:55:45:298
Topic: Spa/rcvQoS: 0 | 126 | 2022-04-26 13:55:45:298
Topic: Spa/rcvQoS: 0 | 5 | 2022-04-26 13:55:45:298
Topic: Spa/rcvQoS: 0 | 191 | 2022-04-26 13:55:45:299
Topic: Spa/rcvQoS: 0 | 6 | 2022-04-26 13:55:45:299
Topic: Spa/rcvQoS: 0 | 92 | 2022-04-26 13:55:45:299
Topic: Spa/rcvQoS: 0 | 126 | 2022-04-26 13:55:45:299
Topic: Spa/rcvQoS: 0 | 16 | 2022-04-26 13:55:45:299
Topic: Spa/rcvQoS: 0 | 126 | 2022-04-26 13:55:45:302
Topic: Spa/rcvQoS: 0 | 7 | 2022-04-26 13:55:45:302
Topic: Spa/rcvQoS: 0 | 16 | 2022-04-26 13:55:45:302
Topic: Spa/rcvQoS: 0 | 191 | 2022-04-26 13:55:45:302
Topic: Spa/rcvQoS: 0 | 17 | 2022-04-26 13:55:45:303
Topic: Spa/rcvQoS: 0 | 0 | 2022-04-26 13:55:45:303
Topic: Spa/rcvQoS: 0 | 62 | 2022-04-26 13:55:45:303
Topic: Spa/rcvQoS: 0 | 126 | 2022-04-26 13:55:45:303
Topic: Spa/rcvQoS: 0 | 126 | 2022-04-26 13:55:45:304
Topic: Spa/rcvQoS: 0 | 126 | 2022-04-26 13:55:45:305
Topic: Spa/rcvQoS: 0 | 5 | 2022-04-26 13:55:45:305
Topic: Spa/rcvQoS: 0 | 16 | 2022-04-26 13:55:45:306
Topic: Spa/rcvQoS: 0 | 191 | 2022-04-26 13:55:45:306
Topic: Spa/rcvQoS: 0 | 6 | 2022-04-26 13:55:45:306
Topic: Spa/rcvQoS: 0 | 126 | 2022-04-26 13:55:45:307
Topic: Spa/rcvQoS: 0 | 7 | 2022-04-26 13:55:45:307
Topic: Spa/rcvQoS: 0 | 16 | 2022-04-26 13:55:45:307
Topic: Spa/rcvQoS: 0 | 92 | 2022-04-26 13:55:45:307
Topic: Spa/rcvQoS: 0 | 191 | 2022-04-26 13:55:45:308
Topic: Spa/rcvQoS: 0 | 17 | 2022-04-26 13:55:45:308
Topic: Spa/rcvQoS: 0 | 0 | 2022-04-26 13:55:45:308
Topic: Spa/rcvQoS: 0 | 62 | 2022-04-26 13:55:45:308
Topic: Spa/rcvQoS: 0 | 126 | 2022-04-26 13:55:45:309
Topic: Spa/rcvQoS: 0 | 126 | 2022-04-26 13:55:45:310
Topic: Spa/rcvQoS: 0 | 126 | 2022-04-26 13:55:45:311
Topic: Spa/rcvQoS: 0 | 126 | 2022-04-26 13:55:45:312
Topic: Spa/rcvQoS: 0 | 5 | 2022-04-26 13:55:45:312
Topic: Spa/rcvQoS: 0 | 191 | 2022-04-26 13:55:45:313
Topic: Spa/rcvQoS: 0 | 6 | 2022-04-26 13:55:45:313
Topic: Spa/rcvQoS: 0 | 92 | 2022-04-26 13:55:45:313
Topic: Spa/rcvQoS: 0 | 16 | 2022-04-26 13:55:45:313
Topic: Spa/rcvQoS: 0 | 126 | 2022-04-26 13:55:45:314
Topic: Spa/rcvQoS: 0 | 7 | 2022-04-26 13:55:45:314
Topic: Spa/rcvQoS: 0 | 16 | 2022-04-26 13:55:45:314
Topic: Spa/rcvQoS: 0 | 191 | 2022-04-26 13:55:45:314
Topic: Spa/rcvQoS: 0 | 17 | 2022-04-26 13:55:45:315
Topic: Spa/rcvQoS: 0 | 0 | 2022-04-26 13:55:45:315
Topic: Spa/rcvQoS: 0 | 62 | 2022-04-26 13:55:45:316
Topic: Spa/rcvQoS: 0 | 126 | 2022-04-26 13:55:45:316
Topic: Spa/rcvQoS: 0 | 5 | 2022-04-26 13:55:45:316
Topic: Spa/rcvQoS: 0 | 16 | 2022-04-26 13:55:45:317
Topic: Spa/rcvQoS: 0 | 191 | 2022-04-26 13:55:45:317
Topic: Spa/rcvQoS: 0 | 6 | 2022-04-26 13:55:45:317
Topic: Spa/rcvQoS: 0 | 92 | 2022-04-26 13:55:45:317
Topic: Spa/rcvQoS: 0 | 126 | 2022-04-26 13:55:45:318
Topic: Spa/rcvQoS: 0 | 126 | 2022-04-26 13:55:45:320
Topic: Spa/rcvQoS: 0 | 7 | 2022-04-26 13:55:45:320
Topic: Spa/rcvQoS: 0 | 16 | 2022-04-26 13:55:45:320
Topic: Spa/rcvQoS: 0 | 191 | 2022-04-26 13:55:45:321
Topic: Spa/rcvQoS: 0 | 17 | 2022-04-26 13:55:45:321
Topic: Spa/rcvQoS: 0 | 0 | 2022-04-26 13:55:45:321
Topic: Spa/rcvQoS: 0 | 62 | 2022-04-26 13:55:45:322
Topic: Spa/rcvQoS: 0 | 126 | 2022-04-26 13:55:45:322
Topic: Spa/rcvQoS: 0 | 5 | 2022-04-26 13:55:45:322
Topic: Spa/rcvQoS: 0 | 191 | 2022-04-26 13:55:45:323
Topic: Spa/rcvQoS: 0 | 6 | 2022-04-26 13:55:45:323
Topic: Spa/rcvQoS: 0 | 92 | 2022-04-26 13:55:45:323
Topic: Spa/rcvQoS: 0 | 16 | 2022-04-26 13:55:45:323
Topic: Spa/rcvQoS: 0 | 126 | 2022-04-26 13:55:45:324
Topic: Spa/rcvQoS: 0 | 7 | 2022-04-26 13:55:45:324
Topic: Spa/rcvQoS: 0 | 16 | 2022-04-26 13:55:45:324
Topic: Spa/rcvQoS: 0 | 0 | 2022-04-26 13:55:45:325
Topic: Spa/rcvQoS: 0 | 17 | 2022-04-26 13:55:45:325
Topic: Spa/rcvQoS: 0 | 191 | 2022-04-26 13:55:45:325
Topic: Spa/rcvQoS: 0 | 126 | 2022-04-26 13:55:45:326
Topic: Spa/rcvQoS: 0 | 5 | 2022-04-26 13:55:45:326
Topic: Spa/rcvQoS: 0 | 16 | 2022-04-26 13:55:45:326
Topic: Spa/rcvQoS: 0 | 62 | 2022-04-26 13:55:45:326
Topic: Spa/rcvQoS: 0 | 6 | 2022-04-26 13:55:45:327
Topic: Spa/rcvQoS: 0 | 92 | 2022-04-26 13:55:45:327
Topic: Spa/rcvQoS: 0 | 126 | 2022-04-26 13:55:45:327
Topic: Spa/rcvQoS: 0 | 191 | 2022-04-26 13:55:45:327
Topic: Spa/rcvQoS: 0 | 126 | 2022-04-26 13:55:45:328
Topic: Spa/rcvQoS: 0 | 16 | 2022-04-26 13:55:45:328
Topic: Spa/rcvQoS: 0 | 191 | 2022-04-26 13:55:45:328
Topic: Spa/rcvQoS: 0 | 7 | 2022-04-26 13:55:45:328
Topic: Spa/rcvQoS: 0 | 17 | 2022-04-26 13:55:45:329

</body>

</html>

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

cribskip, 2022-04-26:
Those "126" markers are the begin and end of transmission bytes (0x7E) see
the wiki for further information, I'm sure now you can spot the telegrams

Gamerayers ***@***.***> schrieb am Di., 26. Apr. 2022, 20:10:

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

Gamerayers, 2022-04-26:
Ah, thats much better....  Just have to read a little better.
The messages are still a little garbled at times and I'm guessing that is just the order that it comes in and the speed that it is being recorded in.
I have tried to make the best of it, and made the table, but also instead the excel data I have in its more raw format.
[mqtt data.xlsx](https://github.com/cribskip/esp8266_spa/files/8566248/mqtt.data.xlsx)

<html xmlns:v="urn:schemas-microsoft-com:vml"
xmlns:o="urn:schemas-microsoft-com:office:office"
xmlns:x="urn:schemas-microsoft-com:office:excel"
xmlns="http://www.w3.org/TR/REC-html40">

[mqtt data.xlsx](https://github.com/cribskip/esp8266_spa/files/8566244/mqtt.data.xlsx)

<head>

<meta name=ProgId content=Excel.Sheet>
<meta name=Generator content="Microsoft Excel 15">
<link id=Main-File rel=Main-File
href="file:///C:/Users/brian/AppData/Local/Temp/msohtmlclip1/01/clip.htm">
<link rel=File-List
href="file:///C:/Users/brian/AppData/Local/Temp/msohtmlclip1/01/clip_filelist.xml">
<style>
<!--table
	{mso-displayed-decimal-separator:"\.";
	mso-displayed-thousand-separator:"\,";}
@page
	{margin:.75in .7in .75in .7in;
	mso-header-margin:.3in;
	mso-footer-margin:.3in;}
tr
	{mso-height-source:auto;}
col
	{mso-width-source:auto;}
br
	{mso-data-placement:same-cell;}
td
	{padding-top:1px;
	padding-right:1px;
	padding-left:1px;
	mso-ignore:padding;
	color:black;
	font-size:11.0pt;
	font-weight:400;
	font-style:normal;
	text-decoration:none;
	font-family:Calibri, sans-serif;
	mso-font-charset:0;
	mso-number-format:General;
	text-align:general;
	vertical-align:bottom;
	border:none;
	mso-background-source:auto;
	mso-pattern:auto;
	mso-protection:locked visible;
	white-space:nowrap;
	mso-rotate:0;}
-->
</style>
</head>

<body link="#0563C1" vlink="#954F72">

7E | 5C | 7 | 11 | 0 | 10 | BF | 3E | 7E
-- | -- | -- | -- | -- | -- | -- | -- | --
7E | 10 | 7 | BF | 11 | 0 | 0 | 3E | 7E
7E | 7 | 10 | 11 | BF | 0 | 0 | 3E | 7E
7E | 5 | 10 | 6 | 5C | BF | 7E |   |  
7E | 7 | 10 | BF | 11 | 0 | 0 | 3E | 7E
7E | 5 | BF | 6 | 5C | 10 | 7E |   |  
7E | 5 | 10 | BF | 6 | 5C | 7E |   |  
7E | 7 | 10 | BF | 11 | 0 | 0 | 3E | 7E
7E | 5 | 10 | BF | 5C | 7E | 6 |   |  
7E | 7 | 10 | BF | 11 | 0 | 0 | 3E | 7E
7E | 5 | 10 | BF | 6 | 5C | 7E |   |  
7E | 5 | 10 | BF | 6 | 5C | 7E |   |  
7E | 7 | 10 | BF | 11 | 0 | 0 | 3E | 7E
7E | 5 | 10 | BF | 6 | 5C | 7E |   |  
7E | 7 | 10 | BF | 11 | 0 | 0 | 3E | 7E
7E | 5 | 10 | BF | 6 | 5C | 7E |   |  
7E | 7 | 10 | BF | 0 | 0 | 11 | 3E | 7E
7E | 5 | BF | 6 | 10 | 5C | 7E |   |  
7E | 7 | 10 | BF | 11 | 0 | 0 | 3E | 7E
7E | 5 | 10 | BF | 6 | 5C | 7E |   |  
7E | 5 | BF | 6 | 5C | 7E | 10 |   |  
7E | 7 | 10 | BF | 0 | 3E | 7E | 0 | 11
7E | 5 | 10 | BF | 6 | 7E | 5C |   |  
7 | 7E | 10 | BF | 11 | 0 | 0 | 3E | 7E
7E | 5 | 10 | BF | 6 | 7E | 5C |   |  
7E | 7 | 10 | 11 | 0 | BF | 0 | 3E | 7E
7E | 5 | BF | 6 | 5C | 10 | 7E |   |  
7E | 7 | 10 | BF | 11 | 0 | 0 | 3E | 7E
7E | 7 | 5C | 6 | 10 | BF | 11 | 0 | 0
7E | 7 | 10 | BF | 11 | 0 | 0 | 3E | 7E
7E | 5 | 10 | BF | 5C | 6 | 7E |   |  
7E | 7 | 10 | BF | 11 | 0 | 0 | 3E | 7E
7E | 5 | 10 | BF | 6 | 5C | 7E |   |  
7E | 7 | 10 | BF | 11 | 0 | 0 | 3E | 7E
7E | 5 | BF | 6 | 5C | 7E | 10 |   |  
7E | 7 | 10 | BF | 11 | 0 | 0 | 3E | 7E
7E | 5 | BF | 6 | 5C | 10 | 7E |   |  
7E | 7 | 10 | BF | 11 | 0 | 0 | 3E | 7E
7E | 5 | 10 | BF | 6 | 5C | 7E |   |  
7E | 7 | 10 | BF | 11 | 0 | 0 | 3E | 7E
5 | 7E | BF | 6 | 5C | 10 | 7E |   |  
7E | 5 | 10 | 3E | 6 | 5C | 7E |   |  

</body>

</html>

cribskip, 2022-04-27:
Looking good but I miss state updates to adress 0xFF (e.g. 7E xx FF ....).
Those messages contain the state of the tub and the data you're looking for

https://github.com/cribskip/esp8266_spa/blob/015e468864a35a08b53799d69ec0e647002d2343/src/esp8266_spa.ino#L962

Gamerayers, 2022-04-28:
How often does that message send?  I logged for a couple minutes and can't find an FF in it at all.  There's over 100,000 hex pair sent, so not sure how much I should log to find this.  Is it only sent every couple minutes? hour? when I turn the hot tub on?
Or should I be logging something other than Spa/rcv?

Gamerayers, 2022-04-29:
Well, I figured out a lot of information over the course of this and made some cool formulas in Excel.  Attached is the messages over about 12 minutes or so, but specifically this:

7E20FFAF1300005D062A00005D0000000000000000000000005D000000780000937E
7E20FFAF1300005D062B00005D0000000000000000000000005D0000007800002A7E
7E20FFAF1300005D062C00005D0000000000000000000000005D0000007800000C7E
7E20FFAF1300005D062D00005D0000000000000000000000005D000000780000B57E
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

Thread 31 (2022-10-26):

Network dropping

Michael0yodi, 2022-10-26:
Hi,

I've been using this since some time, but not without issues, after a cold boot it can run for days or even weeks, and suddenly stops working. I can still see it in Unifi -its connected to an AP, I can see that the DHCP server is constantly offering an IP.

Web server not working and no ping response. I've replaced the D1 Mini with another model but issue persisted, any ideas or have anyone else seen anything similar?
Compiled using Arduino 1.8.15 so maybe I should try and update some libraries?

<html>
<body>
<!--StartFragment-->

2022-10-26T15:48:02 | Informational | dhcpd | Internet Systems Consortium DHCP Server 1 |  
-- | -- | -- | -- | --
2022-10-26T15:47:58 | Informational | dhcpd | DHCPOFFER on 172.16.0.147 to c4:5b:be:54:7f:xx via em0 |  
2022-10-26T15:47:58 | Informational | dhcpd | DHCPDISCOVER from c4:5b:be:54:7f:xx via em0 |  
2022-10-26T15:47:54 | Informational | dhcpd | DHCPOFFER on 172.16.0.147 to c4:5b:be:54:7f:xx via em0 |  
2022-10-26T15:47:54 | Informational | dhcpd | DHCPDISCOVER from c4:5b:be:54:7f:xx via em0 |  
2022-10-26T15:47:52 | Informational | dhcpd | DHCPOFFER on 172.16.0.147 to c4:5b:be:54:7f:xx via em0

<!--EndFragment-->
</body>
</html>

cribskip, 2022-10-26:
Sounds to me like the connection to the spa is instable. Could you please
post a picture of your setup?

Michael ***@***.***> schrieb am Mi., 26. Okt. 2022, 16:01:

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

Michael0yodi, 2022-10-28:
Its just connected mainly using jumper cablers, but should be fine, I've many ESP's like this, I will try and replace the DC-DC converter also even if its been stable at 3v3 when I've checked :)

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

Schubi1, 2022-11-28:
Hi,
i think i have the same problem as you.
It works up to many weeks an then suddenly it doesn t respond.
Curious ist that if ported it to run on an esp32. I thought that is a mistake made by me.
I am also using a unifi controller. how do you get the information aubout the DHCP requests on the unifi controller?
Or did you already find a solution to fix the problem?

Michael0yodi, 2022-11-28:
Hi,

Sorry for not following up on this,

I replaced by dc-dc converter and also changed some wlan settings, disabled BSS Transmission and PMF, if I remember correctly, I had most options disabled from before like minimum data control/fast roaming,  etc. (other esp:s were fine even with them on). This helped me and its been working fine since, but not sure what made the difference or if I was a combination of things

Schubi1, 2022-11-28:
Thanks for that information - i will go testing …

Thread 32 (2023-03-07):

Temp going haywire!

davidmpye, 2023-03-07:
My Spa has been plodding along happily for a week or so, then it seems a confused message led to the temperature thinking it was 70'C where it has persisted...

The MQTT debug output looks like this:

Spa/time/state 07:16
Spa/heatingmode/state ON
Spa/heat_mode/state heat
Spa/heatstate/state OFF
Spa/highrange/state ON
Spa/jet_1/state OFF
Spa/jet_2/state OFF
Spa/circ/state OFF
Spa/blower/state OFF
Spa/light/state OFF
Spa/relay_1/state OFF
Spa/relay_2/state ON
Spa/target_temp/state 35.00
Spa/time/state 07:17
Spa/heatingmode/state ON
Spa/heat_mode/state heat
Spa/heatstate/state OFF
Spa/highrange/state ON
Spa/jet_1/state OFF
Spa/jet_2/state OFF
Spa/circ/state OFF
Spa/blower/state OFF
Spa/light/state OFF
Spa/relay_1/state OFF
Spa/relay_2/state ON
**Spa/node/msg 7e 05 fe bf 00 ac 7e
Spa/node/msg 7e 08 fe bf 02 23 f1 73 ab 7e
Spa/node/id 35**
Spa/target_temp/state 70.00
Spa/time/state 07:18
Spa/heatingmode/state ON
Spa/heat_mode/state heat
Spa/heatstate/state OFF
Spa/highrange/state ON
Spa/jet_1/state OFF
Spa/jet_2/state OFF
Spa/circ/state OFF
Spa/blower/state OFF
Spa/light/state OFF
Spa/relay_1/state OFF
Spa/relay_2/state ON
Spa/target_temp/state 70.00

Not quite sure what has happened, would welcome any suggestions :-)

David

cribskip, 2023-03-07:
Please post a bunch of msg debugs to see if the value for the temp changes.

Also, which rs485 module do you use?

David Pye ***@***.***> schrieb am Di., 7. März 2023, 17:06:

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

davidmpye, 2023-03-10:
Hi

I have had a few more issues of similar problems and one where it crashed the controller, so I am suspecting faulty hardware (likely the RS485 board)

WIll change it and see if that fixes the problem.

I was using this one:

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

David

cribskip, 2023-03-11:
Hey David,

I'm using the same and also see increasing transmission errors in the last
days. On another project one of these got hot to the point where the chip
self destroyed. The quality seems to be fluctuating on these modules.

Anyway, I also suspect the rs485 setup. Could you please do me a favor and
measure the resistance between the two data lines between each other and
ground while the entire pool is shut off? Please disconnect the esp8266 and
rs485 board for the measurements to only inspect the pool.

The resistance especially between the data lines should be around 120 Ohms.
In this case, please remove R7 from the module as it is a superfluous
additional termination resistor.

Good luck and thanks in advance for your feedback
Sascha

David Pye ***@***.***> schrieb am Sa., 11. März 2023, 00:13:

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

Thread 33 (2023-07-02):

Hour and minute

nadlio, 2023-07-02:
Good morning Cribskip

Can you add the possibility of modifying the hour and the minutes in your program.
Thank you so much

Nadlio

nadlio, 2023-07-02:
version Esphome with hour and minute :
https://github.com/jrowny/ESPHomeSpa

nadlio, 2023-07-02:
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

nadlio, 2023-07-02:
Working

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

Thread 34 (2024-06-26):

d1 mini reboot all the time

simplyjeroen, 2024-06-26:
I put the code via arduino on a d1 mini, everything seems to go well. However, the module restarts every 10 seconds, so it never gets into the air properly. anyone have experience with it?

cribskip, 2024-06-27:
The Module resets if it could not initially connect to the wifi or it did
not receive proper data from the whirlpool.

Please verify your wifi credentials

simplyjeroen ***@***.***> schrieb am Mi., 26. Juni 2024,
20:00:

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

simplyjeroen, 2024-06-28:
Well. that was easy. I
had not yet connected it to the jacuzzi. Now connected and working perfectly.

Thread 35 (2024-07-24):

FYI - Created an ESP32 based build

NorthernMan54, 2024-07-24:
Repo is located here - https://github.com/NorthernMan54/esp32_balboa_spa

Code is based on the last commit here - https://github.com/cribskip/esp8266_spa/commit/015e468864a35a08b53799d69ec0e647002d2343

NorthernMan54, 2025-08-29:
Yes fully working in the other repo

ImNoahDev, 2025-08-29:
Awesome just checking because it says:
MQTT Commands are not working yet

NorthernMan54, 2025-08-29:
We should move this to the other REPO

Thread 36 (2024-09-26):

M5 stack help

Doser86, 2024-09-26:
Anyone have a how to and yaml for setting it up on a atom m5 stack?
Have went thru ewerything i feel with no luck. I want to have it only in ESPHome

DadMasterFlex, 2025-04-28:
I know your post is a few months old, but did you ever get this figured out?

Warrior700, 2025-04-30:
I also use an M5 Atom lite [https://docs.m5stack.com/en/core/ATOM%20Lite](url) with an RS485 shield [https://docs.m5stack.com/en/atom/Atomic%20RS485%20Base](url)

The RS485 shield's input voltage isn't limited to +12 V. The SPA mainboard +15.9 V is acceptable. The built-in A0Z1282CI DC/DC converter offers an input voltage range of 4.5 V to 36 V.

**BUT CAUTION: Check the correct pins for + and GND with a multimeter. Otherwise, you could destroy your Atom or possibly your SPA board. (In the worst case scenario.)** picture below

In my first attempts, I only connected A and B . The M5 was powered by a USB powerbank. After that worked, I connected GND and + to the M5/RS485 shield.

I used this cable to connect to the SPA motherboard:  [https://www.amazon.de/dp/B00S6AEMN2?ref_=ppx_hzsearch_conn_dt_b_fed_asin_title_1](url) for this: the red cable is GND, unfortunately, and the yellow one + V but check it with multimeter!!!! A and B are the two black

this is my yaml

```
esphome:
  name: "balboaspa"
  friendly_name: balboa_spa
  #min_version: 2024.10.0
  name_add_mac_suffix: false
  includes:
    - spa_reader.h

  libraries:
    - rlogiacco/CircularBuffer

esp32:
  board: m5stack-atom
  framework:
    type: arduino
    version: latest

external_components:
  - source:
      type: git
      url: https://github.com/robertklep/esphome-custom-component
    components: [ custom, custom_component ]

# Enable logging
logger:
  baud_rate: 0

# Enable Home Assistant API
api:
  encryption:
    key: "insert your key"

# Allow Over-The-Air updates
ota:
- platform: esphome

wifi:
  ssid: !secret wifi_ssid
  password: !secret wifi_password

uart:
  id: spa_uart_bus
  tx_pin: GPIO19
  rx_pin: GPIO22
  data_bits: 8
  parity: NONE
  stop_bits: 1
  baud_rate: 115200
  rx_buffer_size: 128

sensor:
- platform: custom
  lambda: |-
    auto spareader = new SpaReader(id(spa_uart_bus));
    App.register_component(spareader);
    return {spareader->temp_sensor,spareader->target_temp_sensor,spareader->jet1_sensor,spareader->jet2_sensor,
    spareader->light_sensor,spareader->restmode_sensor,spareader->highrange_sensor,spareader->hour_sensor,spareader->minute_sensor,spareader->heater_sensor,spareader->circ_sensor,
    spareader->filt1hour_sensor,spareader->filt1minute_sensor,spareader->filt1durhour_sensor,spareader->filt1durminute_sensor,spareader->filt2enable_sensor,spareader->filt2hour_sensor,
    spareader->filt2minute_sensor,spareader->filt2durhour_sensor,spareader->filt2durminute_sensor};

# if you want to add sensors, every sensor must be in the same order in sensor: and in sensors:

  sensors:
  - name: "Current Temp"
    unit_of_measurement: °C
    accuracy_decimals: 1
  - name: "Target Temp"
    unit_of_measurement: °C
    accuracy_decimals: 1
  - name: "Jet1"
  - name: "Jet2"
 # - name: "Jet3"
  - name: "Light"
  - name: "Rest Mode"
  - name: "High Range"
  - name: "Hour"
  - name: "Minute"
  - name: "Heater"
  - name: "Circulation Pump"
  - name: "Filter 1 Hour"
  - name: "Filter 1 Minute"
  - name: "Filter 1 Duration Hour"
  - name: "Filter 1 Duration Minute"
  - name: "Filter 2 Enable"
  - name: "Filter 2 Hour"
  - name: "Filter 2 Minute"
  - name: "Filter 2 Duration Hour"
  - name: "Filter 2 Duration Minute"
```

and this is my  spa_reader.h

```
#include "esphome.h"
#include <CircularBuffer.hpp>

class SpaReader : public Component, public UARTDevice, public CustomAPIDevice {
 public:
  SpaReader(UARTComponent *parent) : UARTDevice(parent) {}

  float get_setup_priority() const override { return esphome::setup_priority::LATE; }

  CircularBuffer<uint8_t, 35> Q_in;
  CircularBuffer<uint8_t, 35> Q_out;
  uint8_t x, i, j;
  uint8_t last_state_crc = 0x00;
  uint8_t send = 0x00;
  uint8_t settemp = 0x00;
  uint8_t sethour = 0x00;
  uint8_t setminute = 0x00;
  uint8_t id = 0x00;
  unsigned long lastrx = 0;

  uint8_t setfilt1Hour = 0x00;
  uint8_t setfilt1Minute = 0x00;
  uint8_t setfilt1DurationHour = 0x00;
  uint8_t setfilt1DurationMinute = 0x00;
  uint8_t setfilt2HourEnable = 0x00;
  uint8_t setfilt2Minute = 0x00;
  uint8_t setfilt2DurationHour = 0x00;
  uint8_t setfilt2DurationMinute = 0x00;

  char have_config = 0; //stages: 0-> want it; 1-> requested it; 2-> got it; 3-> further processed it
  char have_faultlog = 0; //stages: 0-> want it; 1-> requested it; 2-> got it; 3-> further processed it
  char have_filtersettings = 0; //stages: 0-> want it; 1-> requested it; 2-> got it; 3-> further processed it
  char faultlog_minutes = 0; //temp logic so we only get the fault log once per 5 minutes
  char filtersettings_minutes = 0; //temp logic so we only get the filter settings once per 5 minutes

  float last_proper_temp = 0.0;

  struct { 		//: specifies the amount of bits reserved for the variable
    uint8_t jet1 :1;
    uint8_t jet2 :1;
	uint8_t jet3 :1;
    uint8_t blower :1;
    uint8_t light :1;
    uint8_t restmode:1;
    uint8_t highrange:1;
    uint8_t heater:1;
    uint8_t hour :5;
    uint8_t minutes :6;
    uint8_t circ :1;
  } SpaState;
  struct {
    uint8_t pump1 :2;
    uint8_t pump2 :2;
    uint8_t pump3 :2;
    uint8_t pump4 :2;
    uint8_t pump5 :2;
    uint8_t pump6 :2;
    uint8_t light1 :1;
    uint8_t light2 :1;
    uint8_t circ :1;
    uint8_t blower :1;
    uint8_t mister :1;
    uint8_t aux1 :1;
    uint8_t aux2 :1;
    uint8_t temp_scale :1; //0 -> Farenheit, 1-> Celcius
  } SpaConfig;
  struct {
    uint8_t totEntry :5;
    uint8_t currEntry :5;
    uint8_t faultCode :6;
    String faultMessage;
    uint8_t daysAgo :8;
    uint8_t hour :5;
    uint8_t minutes :6;
  } SpaFaultLog;
  struct {
    uint8_t filt1Hour :5;
    uint8_t filt1Minute :6;
    uint8_t filt1DurationHour :5;
    uint8_t filt1DurationMinute :6;
    uint8_t filt2Enable :1;
    uint8_t filt2Hour :5;
    uint8_t filt2Minute :6;
    uint8_t filt2DurationHour :5;
    uint8_t filt2DurationMinute :6;
  } SpaFilterSettings;

  Sensor *temp_sensor = new Sensor();
  Sensor *target_temp_sensor = new Sensor();
  Sensor *jet1_sensor = new Sensor();
  Sensor *jet2_sensor = new Sensor();
  Sensor *jet3_sensor = new Sensor();
  //Sensor *blower_sensor = new Sensor();
  Sensor *light_sensor = new Sensor();
  Sensor *restmode_sensor = new Sensor();
  Sensor *highrange_sensor = new Sensor();
  Sensor *hour_sensor = new Sensor();
  Sensor *minute_sensor = new Sensor();
  Sensor *heater_sensor = new Sensor();
  Sensor *circ_sensor = new Sensor();
  Sensor *filt1hour_sensor = new Sensor();
  Sensor *filt1minute_sensor = new Sensor();
  Sensor *filt1durhour_sensor = new Sensor();
  Sensor *filt1durminute_sensor = new Sensor();
  Sensor *filt2enable_sensor = new Sensor();
  Sensor *filt2hour_sensor = new Sensor();
  Sensor *filt2minute_sensor = new Sensor();
  Sensor *filt2durhour_sensor = new Sensor();
  Sensor *filt2durminute_sensor = new Sensor();

  uint8_t crc8(CircularBuffer<uint8_t, 35> &data) {
    unsigned long crc;
    int i, bit;
    uint8_t length = data.size();

    crc = 0x02;
    for ( i = 0 ; i < length ; i++ ) {
      crc ^= data[i];
      for ( bit = 0 ; bit < 8 ; bit++ ) {
        if ( (crc & 0x80) != 0 ) {
          crc <<= 1;
          crc ^= 0x7;
        }
        else {
          crc <<= 1;
        }
      }
    }

    return crc ^ 0x02;
  }
  void ID_request() {
    Q_out.push(0xFE);
    Q_out.push(0xBF);
    Q_out.push(0x01);
    Q_out.push(0x02);
    Q_out.push(0xF1);
    Q_out.push(0x73);

    rs485_send();
	ESP_LOGD("Spa/node/id", "Requested ID");
  }
  void ID_ack() {
    Q_out.push(id);
    Q_out.push(0xBF);
    Q_out.push(0x03);

    rs485_send();
  }
  void rs485_send() {
    // Add telegram length
    Q_out.unshift(Q_out.size() + 2);

    // Add CRC
    Q_out.push(crc8(Q_out));

    // Wrap telegram in SOF/EOF
    Q_out.unshift(0x7E);
    Q_out.push(0x7E);

    for (i = 0; i < Q_out.size(); i++) {
      write(Q_out[i]);
    }

    print_msg(Q_out);

    flush();

    // DEBUG: print_msg(Q_out);
    Q_out.clear();
  }
  void print_msg(CircularBuffer<uint8_t, 35> &data) {
    String s;
    //for (i = 0; i < (Q_in[1] + 2); i++) {
    for (i = 0; i < data.size(); i++) {
      x = Q_in[i];
      if (x < 0x0A) s += "0";
      s += String(x, HEX);
      s += " ";
    }
    yield();
  }

  void decodeSettings() {
    ESP_LOGD("Spa/config/status", "Got config");
    SpaConfig.pump1 = Q_in[5] & 0x03;
    SpaConfig.pump2 = (Q_in[5] & 0x0C) >> 2;
    SpaConfig.pump3 = (Q_in[5] & 0x30) >> 4;
    SpaConfig.pump4 = (Q_in[5] & 0xC0) >> 6;
    SpaConfig.pump5 = (Q_in[6] & 0x03);
    SpaConfig.pump6 = (Q_in[6] & 0xC0) >> 6;
    SpaConfig.light1 = (Q_in[7] & 0x03);
    SpaConfig.light2 = (Q_in[7] >> 2) & 0x03;
    SpaConfig.circ = ((Q_in[8] & 0x80) != 0);
    SpaConfig.blower = ((Q_in[8] & 0x03) != 0);
    SpaConfig.mister = ((Q_in[9] & 0x30) != 0);
    SpaConfig.aux1 = ((Q_in[9] & 0x01) != 0);
    SpaConfig.aux2 = ((Q_in[9] & 0x02) != 0);
    SpaConfig.temp_scale = Q_in[3] & 0x01; //Read temperature scale - 0 -> Farenheit, 1-> Celcius
	// ESP_LOGD("Spa/config/pumps1", "Value: ", String(SpaConfig.pump1).c_str());
    // ESP_LOGD("Spa/config/pumps2", "Value: ", String(SpaConfig.pump2).c_str());
    // ESP_LOGD("Spa/config/pumps3", "Value: ", String(SpaConfig.pump3).c_str());
    // ESP_LOGD("Spa/config/pumps4", "Value: ", String(SpaConfig.pump4).c_str());
    // ESP_LOGD("Spa/config/pumps5", "Value: ", String(SpaConfig.pump5).c_str());
    // ESP_LOGD("Spa/config/pumps6", "Value: ", String(SpaConfig.pump6).c_str());
    // ESP_LOGD("Spa/config/light1", "Value: ", String(SpaConfig.light1).c_str());
    // ESP_LOGD("Spa/config/light2", "Value: ", String(SpaConfig.light2).c_str());
    // ESP_LOGD("Spa/config/circ", "Value: ", String(SpaConfig.circ).c_str());
    // ESP_LOGD("Spa/config/blower", "Value: ", String(SpaConfig.blower).c_str());
    // ESP_LOGD("Spa/config/mister", "Value: ", String(SpaConfig.mister).c_str());
    // ESP_LOGD("Spa/config/aux1", "Value: ", String(SpaConfig.aux1).c_str());
    // ESP_LOGD("Spa/config/aux2", "Value: ", String(SpaConfig.aux2).c_str());
    // ESP_LOGD("Spa/config/temp_scale", "Value: ", String(SpaConfig.temp_scale).c_str());
    have_config = 2;
  }
  void decodeState() {
    String s;
    float e = 0.0;
    float d = 0.0;
    float c = 0.0;

    // 25:Flag Byte 20 - Set Temperature
    e = Q_in[25];
    d = e / 2;

    ESP_LOGD("Spa/target_temp/state", "Value: ", String(d, 2).c_str());
    target_temp_sensor->publish_state(d);

    // 7:Flag Byte 2 - Actual temperature
    if (Q_in[7] != 0xFF) {
      e = Q_in[7];
      d = e / 2;
      if (last_proper_temp > 0) {
        if ((d > last_proper_temp * 1.2) || (d < last_proper_temp * 0.8)) d = last_proper_temp; //remove spurious readings greater or less than 20% away from previous read
      }
      ESP_LOGD("Spa/temperature/state", "Value: ", String(d, 2).c_str());
      temp_sensor->publish_state(d);
      last_proper_temp = d;
    } else {
	  if (last_proper_temp == 0.0) {
		//d = 0;
		temp_sensor->publish_state(0.0);
	  }		// This gives an 0 for unknown temperatures, It happens often that the reported temp is 0xFF.
	  ESP_LOGD("Spa/temperature/state", "Reading was nonsense and thus skipped, This is normal");
    }

    // 8:Flag Byte 3 Hour & 9:Flag Byte 4 Minute => Time
    // if (Q_in[8] < 10) s = "0"; else s = "";
    SpaState.hour = Q_in[8];
    // s += String(Q_in[8]) + ":";
    // if (Q_in[9] < 10) s += "0";
    // s += String(Q_in[9]);
    SpaState.minutes = Q_in[9];
    // ESP_LOGD("Spa/time/state", "Value: ", s.c_str());
    sethour = SpaState.hour;
    setminute = SpaState.minutes;
    hour_sensor->publish_state(SpaState.hour);
    minute_sensor->publish_state(SpaState.minutes);

    // 10:Flag Byte 5 - Heat/Rest Mode
    switch (Q_in[10]) {
      case 0x00:
        ESP_LOGD("Spa/heatingmode/state", "ON"); //Ready
        SpaState.restmode = 0;
        restmode_sensor->publish_state(0);
        break;
      case 0x03:// Ready-in-Rest
        SpaState.restmode = 0;
        restmode_sensor->publish_state(0);
        break;
      case 0x01:
        ESP_LOGD("Spa/heatingmode/state", "OFF"); //Rest
        SpaState.restmode = 1;
        restmode_sensor->publish_state(1);
        break;
    }
    // 15:Flags Byte 10 / Heat status, Temp Range
    if (bitRead(Q_in[15], 5) == 0) {	//Heater
      ESP_LOGD("Spa/heatstate/state", "OFF");
      heater_sensor->publish_state(0);
      SpaState.heater = 0;
    } else if (bitRead(Q_in[15], 5) == 1 || bitRead(Q_in[15], 5) == 2) {
      ESP_LOGD("Spa/heatstate/state", "ON");
      heater_sensor->publish_state(1);
      SpaState.heater = 1;
    }
    if (bitRead(Q_in[15], 2) == 0) {	//High range
      ESP_LOGD("Spa/highrange/state", "OFF"); //LOW
      highrange_sensor->publish_state(0);
      SpaState.highrange = 0;
    } else {
      ESP_LOGD("Spa/highrange/state", "ON"); //HIGH
      highrange_sensor->publish_state(1);
      SpaState.highrange = 1;
    }
    // 16:Flags Byte 11 Jets
    if (bitRead(Q_in[16], 1) == 1) {	//Jet1
      ESP_LOGD("Spa/jet_1/state", "ON");
      jet1_sensor->publish_state(1);
      SpaState.jet1 = 1;
    } else {
      ESP_LOGD("Spa/jet_1/state", "OFF");
      jet1_sensor->publish_state(0);
      SpaState.jet1 = 0;
    }
    if (bitRead(Q_in[16], 3) == 1) {	//Jet2
      ESP_LOGD("Spa/jet_2/state", "ON");
      jet2_sensor->publish_state(1);
      SpaState.jet2 = 1;
    } else {
      ESP_LOGD("Spa/jet_2/state", "OFF");
      jet2_sensor->publish_state(0);
      SpaState.jet2 = 0;
    }
	if (bitRead(Q_in[16], 5) == 1) {	//Jet3
      ESP_LOGD("Spa/jet_3/state", "ON");
      jet3_sensor->publish_state(1);
      SpaState.jet3 = 1;
    } else {
      ESP_LOGD("Spa/jet_3/state", "OFF");
      jet3_sensor->publish_state(0);
      SpaState.jet3 = 0;
    }
    // 18:Flags Byte 13 Circulation
    if (bitRead(Q_in[18], 1) == 1) {	//Circulation
      ESP_LOGD("Spa/circ/state", "ON");
      SpaState.circ = 1;
      circ_sensor->publish_state(1);
    } else {
      ESP_LOGD("Spa/circ/state", "OFF");
      SpaState.circ = 0;
      circ_sensor->publish_state(0);
	}
    // 19:Flags Byte 14
    if (Q_in[19] == 0x03) {				//Light
      ESP_LOGD("Spa/light/state", "ON");
      SpaState.light = 1;
      light_sensor->publish_state(1);
    } else {
      ESP_LOGD("Spa/light/state", "OFF");
      SpaState.light = 0;
      light_sensor->publish_state(0);
    }
    last_state_crc = Q_in[Q_in[1]];
  }
  void decodeFilterSettings() {
    // String s;
    // String d;
    // String payld;
	//Read data
    SpaFilterSettings.filt1Hour = Q_in[5];
    SpaFilterSettings.filt1Minute = Q_in[6];
    SpaFilterSettings.filt1DurationHour = Q_in[7];
    SpaFilterSettings.filt1DurationMinute = Q_in[8];
    SpaFilterSettings.filt2Enable = bitRead(Q_in[9],7); // check
    SpaFilterSettings.filt2Hour = Q_in[9]; // ^ (SpaFilterSettings.filt2Enable << 7); // check (idk why XOR it?)
    bitWrite(SpaFilterSettings.filt2Hour, 7, 0); //Discard Enable bit from time value
    SpaFilterSettings.filt2Minute = Q_in[10];
    SpaFilterSettings.filt2DurationHour = Q_in[11];
    SpaFilterSettings.filt2DurationMinute = Q_in[12];

	//Set data for setting settings
	setfilt1Hour = SpaFilterSettings.filt1Hour;
	setfilt1Minute = SpaFilterSettings.filt1Minute;
	setfilt1DurationHour = SpaFilterSettings.filt1DurationHour;
	setfilt1DurationMinute = SpaFilterSettings.filt1DurationMinute;
	setfilt2HourEnable = SpaFilterSettings.filt2Hour ^ (SpaFilterSettings.filt2Enable << 7);
	setfilt2Minute = SpaFilterSettings.filt2Minute;
	setfilt2DurationHour = SpaFilterSettings.filt2DurationHour;
	setfilt2DurationMinute = SpaFilterSettings.filt2DurationMinute;

	//Push data to HA
	filt1hour_sensor->publish_state(SpaFilterSettings.filt1Hour);
	filt1minute_sensor->publish_state(SpaFilterSettings.filt1Minute);
	filt1durhour_sensor->publish_state(SpaFilterSettings.filt1DurationHour);
	filt1durminute_sensor->publish_state(SpaFilterSettings.filt1DurationMinute);
	filt2enable_sensor->publish_state(SpaFilterSettings.filt2Enable);
	filt2hour_sensor->publish_state(SpaFilterSettings.filt2Hour);
	filt2minute_sensor->publish_state(SpaFilterSettings.filt2Minute);
	filt2durhour_sensor->publish_state(SpaFilterSettings.filt2DurationHour);
	filt2durminute_sensor->publish_state(SpaFilterSettings.filt2DurationMinute);

    //Filter 1 time conversion for log
    // if (SpaFilterSettings.filt1Hour < 10) s = "0"; else s = "";
    // s = String(SpaFilterSettings.filt1Hour) + ":";
    // if (SpaFilterSettings.filt1Minute < 10) s += "0";
    // s += String(SpaFilterSettings.filt1Minute);

    // if (SpaFilterSettings.filt1DurationHour < 10) d = "0"; else d = "";
    // d = String(SpaFilterSettings.filt1DurationHour) + ":";
    // if (SpaFilterSettings.filt1DurationMinute < 10) d += "0";
    // d += String(SpaFilterSettings.filt1DurationMinute);

    // payld = "{\"start\":\""+s+"\",\"duration\":\""+d+"\"}";
    // ESP_LOGD("Spa/filter1/state", "Value: ", payld.c_str());

    //Filter 2 time conversion for log
    // if (SpaFilterSettings.filt2Hour < 10) s = "0"; else s = "";
    // s += String(SpaFilterSettings.filt2Hour) + ":";
    // if (SpaFilterSettings.filt2Minute < 10) s += "0";
    // s += String(SpaFilterSettings.filt2Minute);

    // if (SpaFilterSettings.filt2DurationHour < 10) d = "0"; else d = "";
    // d += String(SpaFilterSettings.filt2DurationHour) + ":";
    // if (SpaFilterSettings.filt2DurationMinute < 10) d += "0";
    // d += String(SpaFilterSettings.filt2DurationMinute);
    // if ((int)(SpaFilterSettings.filt2Enable) == 1) ESP_LOGD("Spa/filter2_enabled/state", "ON"); else ESP_LOGD("Spa/filter2_enabled/state", "OFF");

    // payld = "{\"start\":\""+s+"\",\"duration\":\""+d+"\"}";
    // ESP_LOGD("Spa/filter2/state", "Value: ", payld.c_str());

    have_filtersettings = 2;
	ESP_LOGD("Spa/debug/have_filtersettings", "have the filter settings, #2");
  }
  void decodeFault() {
    SpaFaultLog.totEntry = Q_in[5];
    SpaFaultLog.currEntry = Q_in[6];
    SpaFaultLog.faultCode = Q_in[7];
    switch (SpaFaultLog.faultCode) { // this is a inelegant way to do it, a lookup table would be better
      case 15:
        SpaFaultLog.faultMessage = "Sensors are out of sync";
        break;
      case 16:
        SpaFaultLog.faultMessage = "The water flow is low";
        break;
      case 17:
        SpaFaultLog.faultMessage = "The water flow has failed";
        break;
      case 18:
        SpaFaultLog.faultMessage = "The settings have been reset";
        break;
      case 19:
        SpaFaultLog.faultMessage = "Priming Mode";
        break;
      case 20:
        SpaFaultLog.faultMessage = "The clock has failed";
        break;
      case 21:
        SpaFaultLog.faultMessage = "The settings have been reset";
        break;
      case 22:
        SpaFaultLog.faultMessage = "Program memory failure";
        break;
      case 26:
        SpaFaultLog.faultMessage = "Sensors are out of sync -- Call for service";
        break;
      case 27:
        SpaFaultLog.faultMessage = "The heater is dry";
        break;
      case 28:
        SpaFaultLog.faultMessage = "The heater may be dry";
        break;
      case 29:
        SpaFaultLog.faultMessage = "The water is too hot";
        break;
      case 30:
        SpaFaultLog.faultMessage = "The heater is too hot";
        break;
      case 31:
        SpaFaultLog.faultMessage = "Sensor A Fault";
        break;
      case 32:
        SpaFaultLog.faultMessage = "Sensor B Fault";
        break;
      case 34:
        SpaFaultLog.faultMessage = "A pump may be stuck on";
        break;
      case 35:
        SpaFaultLog.faultMessage = "Hot fault";
        break;
      case 36:
        SpaFaultLog.faultMessage = "The GFCI test failed";
        break;
      case 37:
        SpaFaultLog.faultMessage = "Standby Mode (Hold Mode)";
        break;
      default:
        SpaFaultLog.faultMessage = "Unknown error";
        break;
    }
    SpaFaultLog.daysAgo = Q_in[8];
    SpaFaultLog.hour = Q_in[9];
    SpaFaultLog.minutes = Q_in[10];
    ESP_LOGD("Spa/fault/Entries", "Value: ", String(SpaFaultLog.totEntry).c_str());
    ESP_LOGD("Spa/fault/Entry", "Value: ", String(SpaFaultLog.currEntry).c_str());
    ESP_LOGD("Spa/fault/Code", "Value: ", String(SpaFaultLog.faultCode).c_str());
    ESP_LOGD("Spa/fault/Message", "Value: ", SpaFaultLog.faultMessage.c_str());
    ESP_LOGD("Spa/fault/DaysAgo", "Value: ", String(SpaFaultLog.daysAgo).c_str());
    ESP_LOGD("Spa/fault/Hours", "Value: ", String(SpaFaultLog.hour).c_str());
    ESP_LOGD("Spa/fault/Minutes", "Value: ", String(SpaFaultLog.minutes).c_str());
    have_faultlog = 2;
    ESP_LOGD("Spa/debug/have_faultlog", "have the faultlog, #2");
  }

  void on_set_temp(float temp) {
    if (temp >= 26 || temp <= 40) {
      settemp = temp * 2;
      send = 0xff;
    }
  }
  void on_set_clock(int hour, int minute) {
    if((hour >= 0 || hour <= 23) && (minute >= 0 || minute <= 59)) {
      sethour = hour;
	  setminute = minute;
      send = 0x21;
    } else {
      ESP_LOGD("Spa/SetValues/Clock", "Invalid variable values!");
    }
  }
  void on_set_filtration(int f1hour, int f1min, int f1durhour, int f1durmin, int f2enab, int f2hour, int f2min, int f2durhour, int f2durmin) {
    if((f1hour >= 0 || f1hour <= 23) && (f1min >= 0 || f1min <= 59) && (f1durhour >= 0 || f1durhour <= 23) && (f1durmin >= 0 || f1durmin <= 59) && (f2enab == 0 || f2enab == 1) && (f2hour >= 0 || f2hour <= 23) && (f2min >= 0 || f2min <= 23) && (f2durhour >= 0 || f2durhour <= 23) && (f2durmin >= 0 || f2durmin <= 23)) {
	  setfilt1Hour = f1hour;
	  setfilt1Minute = f1min;
	  setfilt1DurationHour = f1durhour;
	  setfilt1DurationMinute = f1durmin;
	  setfilt2HourEnable = f2hour ^ (f2enab << 7);
	  setfilt2Minute = f2min;
	  setfilt2DurationHour = f2durhour;
	  setfilt2DurationMinute = f2durmin;
      have_filtersettings = 0; //Re-request settings after change
      send = 0x23;
    } else {
      ESP_LOGD("Spa/SetValues/Filtration", "Invalid variable values!");
    }
  }
  void on_toggle_heatingmode() {
    send = 0x51;
  }
  void on_toggle_range() {
    send = 0x50;
  }
  void on_toggle_light() {
    send = 0x11;
  }
  void on_toggle_jet1() {
    send = 0x04;
  }
  void on_toggle_jet2() {
    send = 0x05;
  }
  void on_toggle_jet3() {
    send = 0x06;
  }
  void on_request_filter(){
	  have_filtersettings = 0;
  }

  void setup() override {
    Q_in.clear();
    Q_out.clear();
    register_service(&SpaReader::on_set_temp, "set_target_temp", {"temp"});
    // register_service(&SpaReader::on_set_hour, "set_hour", {"hour"});
    // register_service(&SpaReader::on_set_minute, "set_minute", {"minute"});
	register_service(&SpaReader::on_set_clock, "set_clock", {"hour","minute"});
    register_service(&SpaReader::on_toggle_light, "toggle_light");
    register_service(&SpaReader::on_toggle_jet1, "toggle_jet1");
    register_service(&SpaReader::on_toggle_jet2, "toggle_jet2");
	register_service(&SpaReader::on_toggle_jet3, "toggle_jet3");
    register_service(&SpaReader::on_toggle_heatingmode, "toggle_heatingmode");
    register_service(&SpaReader::on_toggle_range, "toggle_range");
	register_service(&SpaReader::on_request_filter, "request_filter");
    register_service(&SpaReader::on_set_filtration, "set_filtration", {"filter1hour","filter1minute","filter1durationhour","filter1durationminute","filter2enable","filter2hour","filter2minute","filter2durationhour","filter2durationminute"});

  }

  void loop() override {
    yield();
    while (available()) {
      x = read();
      Q_in.push(x);

      // Drop until SOF is seen
      if (Q_in.first() != 0x7E) {
        Q_in.clear();
      }

      // Double SOF-marker, drop last one
      if (Q_in[1] == 0x7E && Q_in.size() > 1) Q_in.pop();

      // Complete package
      //if (x == 0x7E && Q_in[0] == 0x7E && Q_in[1] != 0x7E) {
      if (x == 0x7E && Q_in.size() > 2) {

        // Unregistered or yet in progress
        if (id == 0) {
          //ESP_LOGD("Spa/node/id", "Unregistered");
          if (Q_in[2] == 0xFE) {
			  print_msg(Q_in);
			  ESP_LOGD("Spa/node/id", "Unregistered");
		  }
          //print_msg(Q_in);
          // FE BF 02:got new client ID
          if (Q_in[2] == 0xFE && Q_in[4] == 0x02) {
            id = Q_in[5];
            if (id > 0x2F) id = 0x2F;
            ESP_LOGD("Spa/node/id", "Got ID, acknowledging");
            ID_ack();
			ESP_LOGD(String(id).c_str(), "Spa/node/id");
          }
          // FE BF 00:Any new clients?
          if (Q_in[2] == 0xFE && Q_in[4] == 0x00) {
            ESP_LOGD("Spa/node/id", "Requesting ID");
            ID_request();
          }
        }
		else if (Q_in[2] == id && Q_in[4] == 0x06) { // we have an ID, do clever stuff
            // id BF 06:Ready to Send
            if (send == 0x21) {
              Q_out.push(id);
              Q_out.push(0xBF);
              Q_out.push(0x21);
              Q_out.push(sethour);
              Q_out.push(setminute);
            } else if (send == 0xff) {
              // 0xff marks dirty temperature for now
              Q_out.push(id);
              Q_out.push(0xBF);
              Q_out.push(0x20);
              Q_out.push(settemp);
			} else if (send == 0x23) { // Set filter times
              Q_out.push(id);
              Q_out.push(0xBF);
              Q_out.push(0x23);
			  Q_out.push(setfilt1Hour);
			  Q_out.push(setfilt1Minute);
			  Q_out.push(setfilt1DurationHour);
			  Q_out.push(setfilt1DurationMinute);
			  Q_out.push(setfilt2HourEnable);
			  Q_out.push(setfilt2Minute);
			  Q_out.push(setfilt2DurationHour);
			  Q_out.push(setfilt2DurationMinute);
            } else if (send == 0x00) {
              if (have_config == 0) { // Get configuration of the hot tub
                Q_out.push(id);
                Q_out.push(0xBF);
                Q_out.push(0x22);
                Q_out.push(0x00);
                Q_out.push(0x00);
                Q_out.push(0x01);
                ESP_LOGD("Spa/config/status", "Getting config");
                //have_config = 1;
              } else if ((have_faultlog == 0) && (have_config == 2)) { // Get the fault log
                Q_out.push(id);
                Q_out.push(0xBF);
                Q_out.push(0x22);
                Q_out.push(0x20);
                Q_out.push(0xFF);
                Q_out.push(0x00);
                //have_faultlog = 1;
                ESP_LOGD("Spa/debug/have_faultlog", "requesting fault log, #1");
              } else if ((have_filtersettings == 0) && (have_faultlog == 2)) { // Get the filter cycles log once we have the faultlog
                Q_out.push(id);
                Q_out.push(0xBF);
                Q_out.push(0x22);
                Q_out.push(0x01);
                Q_out.push(0x00);
                Q_out.push(0x00);
                ESP_LOGD("Spa/debug/have_filtersettings", "requesting filter settings, #1");
                //have_filtersettings = 1;
              } else {
                // A Nothing to Send message is sent by a client immediately after a Clear to Send message if the client has no messages to send.
                Q_out.push(id);
                Q_out.push(0xBF);
                Q_out.push(0x07);
              }
            } else {
              // Send toggle commands
              Q_out.push(id);
              Q_out.push(0xBF);
              Q_out.push(0x11);
              Q_out.push(send);
              Q_out.push(0x00);
            }

            rs485_send();
            send = 0x00;
        } else if (Q_in[2] == id && Q_in[4] == 0x2E) {
          if (last_state_crc != Q_in[Q_in[1]]) {
            decodeSettings();
          }
        } else if (Q_in[2] == id && Q_in[4] == 0x28) {
          if (last_state_crc != Q_in[Q_in[1]]) {
            decodeFault();
          }
        } else if (Q_in[2] == 0xFF && Q_in[4] == 0x13) { // FF AF 13:Status Update - Packet index offset 5
          if (last_state_crc != Q_in[Q_in[1]]) {
            decodeState();
          }
        } else if (Q_in[2] == id && Q_in[4] == 0x23) { // FF AF 23:Filter Cycle Message - Packet index offset 5
          if (last_state_crc != Q_in[Q_in[1]]) {
            ESP_LOGD("Spa/debug/have_faultlog", "decoding filter settings");
            decodeFilterSettings();
          }
        } //else {
          // DEBUG for finding meaning
          //if (Q_in[2] & 0xFE || Q_in[2] == id)
          //print_msg(Q_in);
        //}

        // Clean up queue
        yield();
        Q_in.clear();
      }
      lastrx = millis();
    }
  }
};

```

i copied the spa_reader.h in the directory to HA  \config\esphome\spa_reader.h

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

Doser86, 2025-04-30:
> I know your post is a few months old, but did you ever get this figured out?

No. I have trouble finding rx and tx. I have 5 boards at home now that don't work with my spa wiring 😂

Thread 37 (2025-03-28):

Connected to wifi... but no data

heinekmadsen, 2025-03-28:
Hi...

So I have been trying to get this to work with my balboa control box in my spa for several hours/days now.

I'm using a Wemos D1 Mini Pro with a RS485 to TTL ( https://www.amazon.it/RS485-adattatore-Serial-Level-Converter-Module/dp/B0716VF1CC )

Wiring:
DC-DC converter set to output 3.3v
Wemos TX to RS485 TX
Wemos RX to RS485 RX
Wemos GND + RS485 GND + DC-DC output GND
RS485 A to SPA A
RS485 B to SPA B

I have commented out the hard reset lines in the code.
I can verify that it connects to Wifi AND it connects to my MQTT broker.

However... i no data i received from the SPA.

I have tried to find the solution in the issues "archive" but no luck.

any advise is much appreciated.

cribskip, 2025-03-28:
Hi, do you get readings on Spa/node/msg? There's a loop reading the
messages, maybe debug there and print/transfer the received data by mqtt.

Best,
Sascha

heinekmadsen ***@***.***> schrieb am Fr., 28. März 2025,
17:46:

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

heinekmadsen, 2025-03-28:
Well... All i get i mqtt is this:

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

I found a fork of your repo where the readme states that it has to be a MAX13487 chip on the TTL converter.
I'm not sure if mine has a MAX485 or a MAX13487.

heinekmadsen, 2025-03-28:
Tried zooming with my phone on the chip... i can barely see it... but what i can see looks like its a MAX485
