cribskip/esp8266_spa/(commit log)

2021-01-01 Fix for previous commit (remove TX485)
    [balboa_helper.ino]
2021-01-01 Handle MQTT brokers that require a login and password. Try fix for spurious temperature readings.
    [esp8266_spa.ino]
2021-01-02 Fix fo 1m flash size Fix for spurious temperatures
    [esp8266_spa.ino]
2021-01-07 Improvement to Hassio autodetect (doesn't fully work yet)
    [esp8266_spa.ino]
2021-01-09 Fixed HomeAssistant autodiscovery (for real) - need to bear in mind pubsubclient character limit (or find a workaround)
    [esp8266_spa.ino]
2021-01-16 Read Spa config and publish to MQTT - next step: pub sub for the correct config
    [esp8266_spa.ino]
2021-01-30 fix for fault log to get the last entry
    [esp8266_spa.ino]
2021-01-31 v0.30: - republish mqtt configuration if mqtt broker has to reconnect - Hassio temperature is now a climate device (needs more work) - increased mqtt message size to 512 bytes
    [esp8266_spa.ino]
2021-02-02 0.31: - board is actually a wemos d1 mini [it's a fake pro] - tidy up if code (such that primary decision tree is 'do I have an id, yes/no') - add more chip debug info - prep LittleFS for config savi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
2021-02-03 0.32: - fixed a code regression - clean up 'have id' vs 'don't have id' logic
    [esp8266_spa.ino]
2021-02-03 0.33: - fixed AUTO_TX bug for chips that require D1 to pull high/low to transmit / receive (thank you @cribskip) - add http client handler in _yield (thank you @cribskip)
    [balboa_helper.ino, esp8266_spa.ino]
2021-02-04 Fixes relay handling
    Fixes #8
    Handler and subscriber were different
    [esp8266_spa.ino]
2021-02-14 0.34: - wifi/mqtt settings now saved to a local file to make firmware upgrades simpler - current workflow as follows: 1. enter your wifi/mqtt settings, set SAVE_CONN to true 2. compile, upload as nor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
2021-02-27 0.35: - finish HomeAssistant climate device integration
2021-03-02 Fix relay handling
2021-04-05 0.36: - read filter cycles
2021-04-08 0.36(again): - red filter cycles and publish to homeassistant properly
2021-05-15 0.37: - ArduinoOta - code tidy up to allow MDNS (doesn't work on my system)
    [esp8266_spa.ino]
2021-07-10 v0.37.2 - try a fix for mqtt not reconnecing when HASS reboots
    [esp8266_spa.ino]
2021-07-11 v0.37.3: - Detect Farenheit temperature scale and configure home-assistant - fix regression for mqtt autoconfigure
    [esp8266_spa.ino]
2021-07-11 v0.37.4: - add retain flag to autodiscovery - fix autoconfigure regression when first booting
    [esp8266_spa.ino]
